Leehyunbin0131/dog/THIRD_PARTY_NOTICES.md

# Third-party notices

## ROBOTIS DYNAMIXEL references

ROBOTIS is the source of XL430-W250 / XM430-W210 actuator and horn reference geometry and dimensional information used in assembly documents and CAD reference objects. These are reference components, not user-designed or printable motor parts. Their inclusion in a composite assembly or render does not transfer their copyright to this project. No blanket open-source license or commercial redistribution permission for manufacturer CAD is asserted.

- XL430-W250: https://emanual.robotis.com/docs/en/dxl/x/xl430-w250/
- XM430-W210: https://emanual.robotis.com/docs/en/dxl/x/xm430-w210/
- XL drawing: https://www.robotis.com/service/download.php?no=772
- XM drawing: https://www.robotis.com/service/download.php?no=157

The complete manufacturer download archives are not mirrored. Native assembly/part files may include reference geometry; original mechanical derivative licensing does not override manufacturer rights. Printed spacer reference geometry is identified by its file name and is not an assertion of ownership over the corresponding stock hardware.

## Original Micro_Dog

Original mechanical work: © 2026 moieboy9999, CC BY-NC-SA 4.0. `licenses/UPSTREAM_ATTRIBUTION.md` is preserved for provenance, including inspiration and upstream third-party credits. No Unitree, Rhoban Microban, Pollen PCB, or Raspberry Pi third-party source is newly included by this adaptation.

## Fonts

The assembly PDF embeds renamed subsets derived from Noto Sans CJK, licensed under SIL Open Font License 1.1. The upstream font copyright and license are in `licenses/NOTO-OFL.txt`. Full font files are not redistributed. REV 3 includes renamed Noto-derived TrueType subset fonts and their generation/conversion scripts under docs/assembly/manual_v2/source; the font remains under SIL OFL 1.1.
