Leehyunbin0131/dog/ATTRIBUTION.md

# Attribution and modifications

## Original mechanical design

Micro_Dog, © 2026 moieboy9999: https://github.com/moieboy9999/Micro_Dog

Upstream reviewed commit: `68373f962d8916d3e81a07630844f12e3dfbe927`.
The original STEP supplied the mechanical design basis. Original license and attribution are retained in `LICENSE` and `licenses/UPSTREAM_ATTRIBUTION.md`.

Mechanical adaptations made in this X430 project include approximately 1.5× leg outlines; actual-size XL430/XM430 interfaces; motor clearance and cable passages; MR137ZZ 7×13×4 bearing stacks; retaining caps; mirrored left/right parts; roll carriers, pelvis yokes and fixed bearing support; finish/clearance changes; printed spacer references; and explanatory assembly documentation. The parametrized central body is a placeholder, not an original-body reproduction or completed structural design.

The resulting mechanical derivatives, CAD, STEP, STL, derived URDF/meshes, parameters and documentation are distributed under Creative Commons Attribution-NonCommercial-ShareAlike 4.0 International, subject to third-party exclusions below. Changes are not endorsed by the original author.
https://creativecommons.org/licenses/by-nc-sa/4.0/

## Software

Newly authored helper/generation/validation scripts are GPL-3.0-or-later, see `LICENSE-SOFTWARE`. The original project's control software, training scripts and policy weights are not copied into this repository. No claim is made that the original XL330 policy works with this X430 mechanism.

## Third-party exclusions

ROBOTIS actuator/horn reference geometry and other manufacturer data retain their respective rights; this project does not claim ownership or apply CC/GPL to those assets. See `THIRD_PARTY_NOTICES.md` for sources and scope. The upstream attribution file describes upstream content, not a declaration that every upstream asset is redistributed here.
