Leehyunbin0131/dog/docs/CAD_SOURCES.md

# Selected CAD editing sources

These documents preserve the relevant editable work, including hidden intermediate/reference objects. Exported final STL/STEP remains authoritative; source documents have not been fully recomputed or proven feature-by-feature equivalent. Select the final body rather than exporting every object.

- `RR_XL430_thigh_finish_v2_fine005.stl`: `cad/freecad/parts/RR_XL430_thigh_finish_v2_lean.FCStd`
- `LH_XL430_thigh_finish_v2_fine005.stl`: `cad/freecad/parts/LH_XL430_thigh_finish_v2.FCStd`
- `RR_shank_MR137ZZ4_fine005.stl`: `cad/freecad/parts/RR_shank_MR137ZZ4_working.FCStd`
- `LH_shank_MR137ZZ4_fine005.stl`: `cad/freecad/parts/LH_shank_MR137ZZ4.FCStd`
- `RR_shank_companion_original_shape_fine005.stl`: `cad/freecad/parts/RR_shank_companion_original_shape_working.FCStd`
- `LH_shank_companion_fine005.stl`: `cad/freecad/parts/LH_shank_companion.FCStd`
- `RR_XL430_knee_crank_original_shape_fine005.stl`: `cad/freecad/parts/RR_XL430_knee_crank_original_shape_working.FCStd`
- `RR_pushrod_original_shape_fine005.stl`: `cad/freecad/parts/RR_pushrod_original_shape_working.FCStd`
- `Large_retaining_cap_MR137ZZ4_fine005.stl`: `cad/freecad/parts/Large_retaining_cap_MR137ZZ4_working.FCStd`
- `Small_retaining_cap_original_fine005.stl`: `cad/freecad/parts/Small_retaining_cap_original.FCStd`
- `RR_foot_original_shape_fine005.stl`: `cad/freecad/parts/RR_foot_original_shape_working.FCStd`
- `XM430_roll_horn_carrier_finish_fine005.stl`: `cad/freecad/parts/XM430_roll_horn_carrier_finish.FCStd`
- `XL430_roll_bearing_carrier_MR137ZZ4_clearance_v2_fine005.stl`: `cad/freecad/parts/XL430_roll_bearing_carrier_MR137ZZ4_clearance_v2.FCStd`
- `Pelvis_roll_support_MR137ZZ4_clearance03_fine005.stl`: `cad/freecad/parts/Pelvis_roll_support_MR137ZZ4.FCStd`
- `RR_XM430_pelvis_yoke_checked_fine005.stl`: `cad/freecad/parts/RR_XM430_pelvis_yoke_working.FCStd`
- `LR_XM430_pelvis_yoke_fine005.stl`: `cad/freecad/parts/LR_XM430_pelvis_yoke.FCStd`
- `XL430_keyed_spacer_reference.stl`: `cad/freecad/parts/XL430_keyed_spacer_reference.FCStd`
- `XM430_case_spacer_reference_fine005.stl`: `cad/freecad/parts/XM430_case_spacer_reference.FCStd`

The exported STEP/STL specifies the final clearance03 support shape; inspect the source feature selection before re-exporting. Use restore_packed_files.py before opening the packed right-thigh document.
