Leehyunbin0131/dog/docs/assembly/manual_v2/assets/overview.png

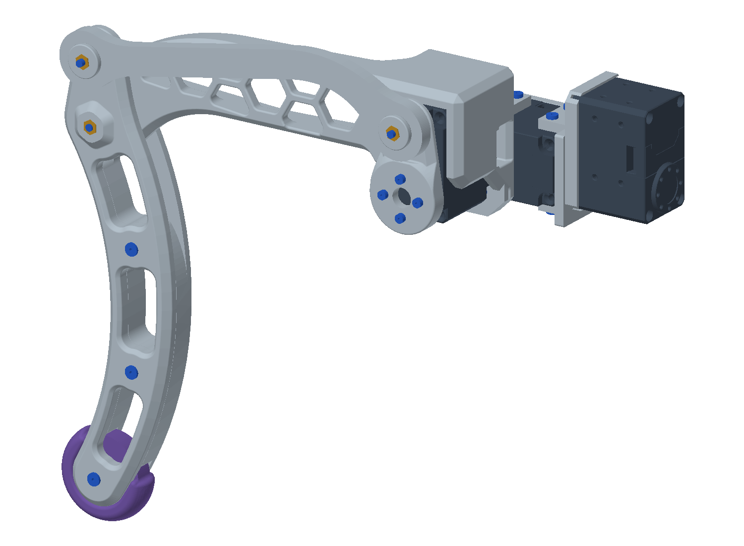
docs/assembly/manual_v2/assets/overview.png
