Leehyunbin0131/dog/images/62_RR_complete_leg_pelvis.jpg

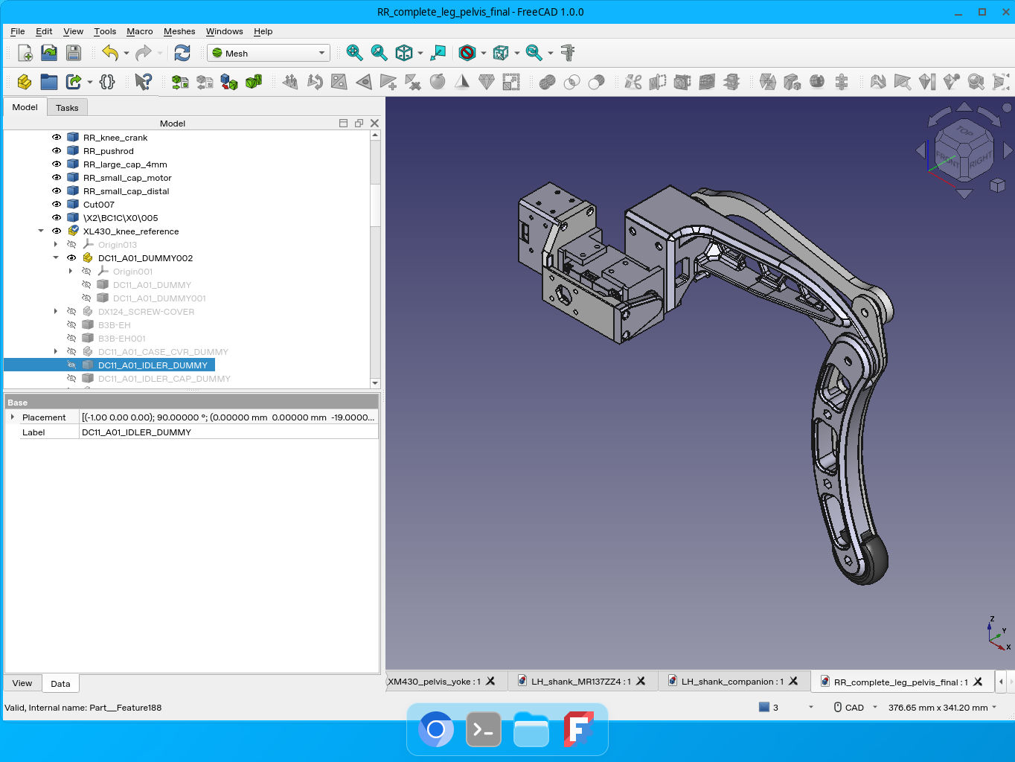
images/62_RR_complete_leg_pelvis.jpg
