Leehyunbin0131/dog/images/assembly/overview_a.png

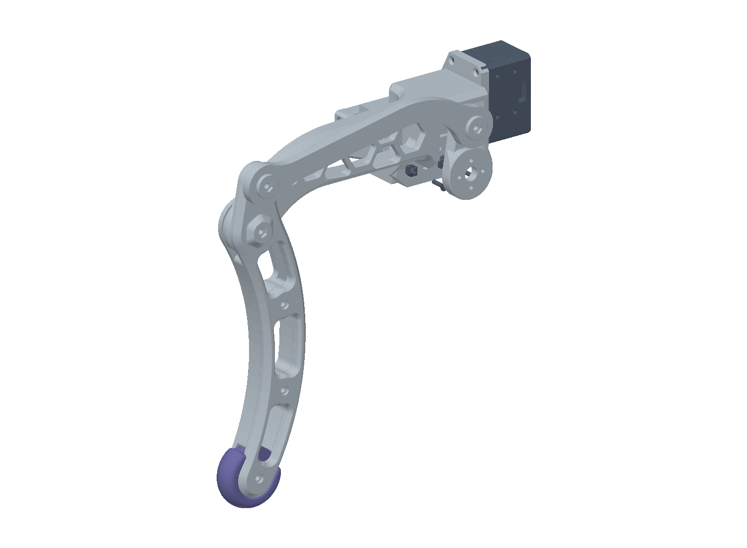
images/assembly/overview_a.png
