Leehyunbin0131/dog/docs/bom/printed_parts.csv

file | quantity | material | sha256
RR_XL430_thigh_finish_v2_fine005.stl | 2 | PLA | 6c28571a567d9a42b985946fea726201387cbd39cf7ea6b7587750b2f6ee943d
LH_XL430_thigh_finish_v2_fine005.stl | 2 | PLA | 9047f457ac42e8384424c823f7730fb696b8dfba642826761f44a489e81a110a
RR_shank_MR137ZZ4_fine005.stl | 2 | PLA | 9bbbfd65d6c0c338eb0b5cd08ecb12a54b652a8e96e306e003762d8ae54926e9
LH_shank_MR137ZZ4_fine005.stl | 2 | PLA | e1fa2028df4a93b5aff54ae1f663ef85ef9a0ecc1adec51dea8764f1c51b33ef
RR_shank_companion_original_shape_fine005.stl | 2 | PLA | ee0035df773160c7955a39d78ee668ffdc51e8afffd88681a85cce93f338b44b
LH_shank_companion_fine005.stl | 2 | PLA | 5df619ce2be21cb59259313106f591cdb59da83122bb4a03e0deb2da20906122
RR_XL430_knee_crank_original_shape_fine005.stl | 4 | PLA | 31f4d15e81daaf4329c76fde653677bb7d7fda65d8bbd32a9f8b8b8a7bb69c35
RR_pushrod_original_shape_fine005.stl | 4 | PLA | 095c1817cce63f73ddd0a658bb03e86bc8751b4c14e85299a5c08ce808242eee
Large_retaining_cap_MR137ZZ4_fine005.stl | 4 | PLA | 7b30682414906283c338cf347638e11aca3248c5bf40cbc997aa26874cf67d39
Small_retaining_cap_original_fine005.stl | 8 | PLA | ebaca69c9e65529709f184d23aeefeb28cba8705a0ec41c2ece9f4bec49af1ac
RR_foot_original_shape_fine005.stl | 4 | TPU95A | b5f29c3139329bb3a87ade8e3d312d9ac05d0036e463541a5a33e61598ef6748
XM430_roll_horn_carrier_finish_fine005.stl | 4 | PLA | e86779746acdd896fff15bee71d8153953dc7c26abd656b7c8151430c3bf7862
XL430_roll_bearing_carrier_MR137ZZ4_clearance_v2_fine005.stl | 4 | PLA | 5f95768f4dd9f3e8be56aca34b6cd4f709481c88ac20f55eb0a12fd7e7cb75df
Pelvis_roll_support_MR137ZZ4_clearance03_fine005.stl | 4 | PLA | 54bcd5b0998d45053a7d4befbd47951f954cba6353021bfae742af6fe5540ecc
RR_XM430_pelvis_yoke_checked_fine005.stl | 2 | PLA | ce570233bcb73c30af040ecb0e3a2f796170e2a8956bcaf9481e6f54b6487a49
LR_XM430_pelvis_yoke_fine005.stl | 2 | PLA | 94ebef8037e834c960f617b63dbd2d54cc14bb8e4b26ea74edc224b8c4df1634
XL430_keyed_spacer_reference.stl | 16 | PLA | 850a73b3b3b96892e2e7f3600beac49e5b664ec0a3137b1146a798042436e7ad
XM430_case_spacer_reference_fine005.stl | 16 | PLA | ac34d69db38a92e00b66f873a88f1ec3ee2fa27da3384529a1e3f1a959acd1fa
