Leehyunbin0131/dog/cad/freecad/assemblies/RR_complete_leg_pelvis_final.FCStd

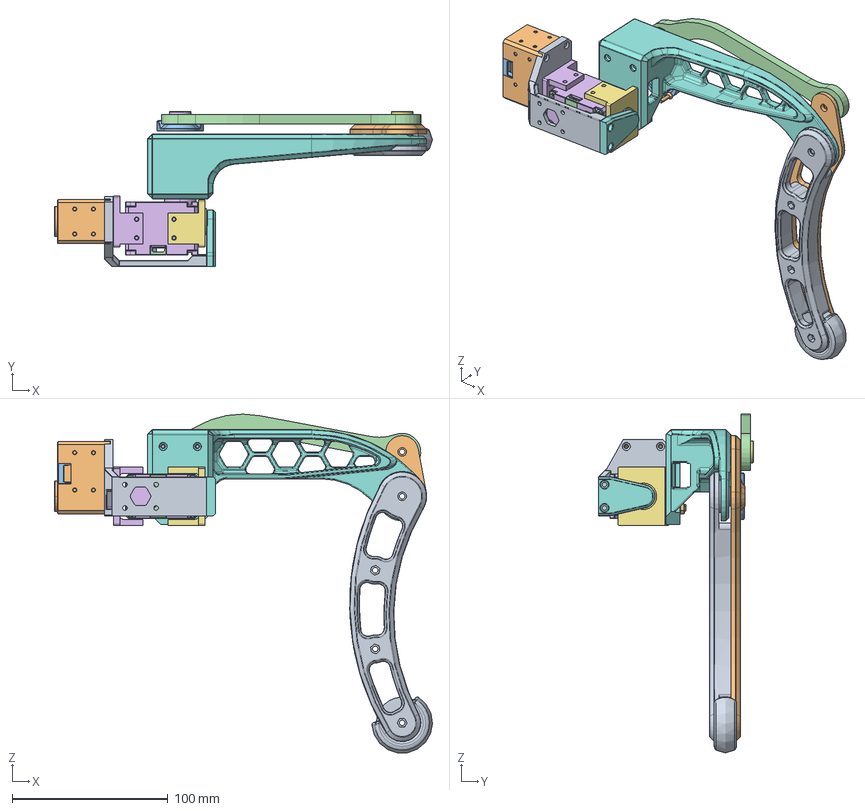
[picture p5: CAD file, 2026-10-17]
cad/freecad/assemblies/RR_complete_leg_pelvis_final.FCStd
242.7 x 99.8 x 217.6 mm
RR_inner_shank_4mm
RR_companion_shank
RR_knee_crank
RR_pushrod
RR_large_cap_4mm
RR_small_cap_motor
RR_small_cap_distal
\X2\BC1C\X0\005
DC11_A01_SPACER_DUMMY004
DC11_A01_SPACER_DUMMY005
DC11_A01_SPACER_DUMMY006
DC11_A01_SPACER_DUMMY007
DC11_A01_DUMMY003
DC11_A01_DUMMY004
B3B-EH002
B3B-EH003
DUMMY_DC12_3
WBH_M2_5X12_012
WBH_M2_5X12_013
WBH_M2_5X12_014
WBH_M2_5X12_015
DC12_A01_SPACER_RING_1_006
DC12_A01_SPACER_RING_1_007
DC12_A01_SPACER_RING_1_008
DC12_A01_SPACER_RING_1_009
DC12_A01_CVR_CABLE_5_1
