Leehyunbin0131/dog/cad/freecad/parts/RR_pushrod_original_shape_working.FCStd

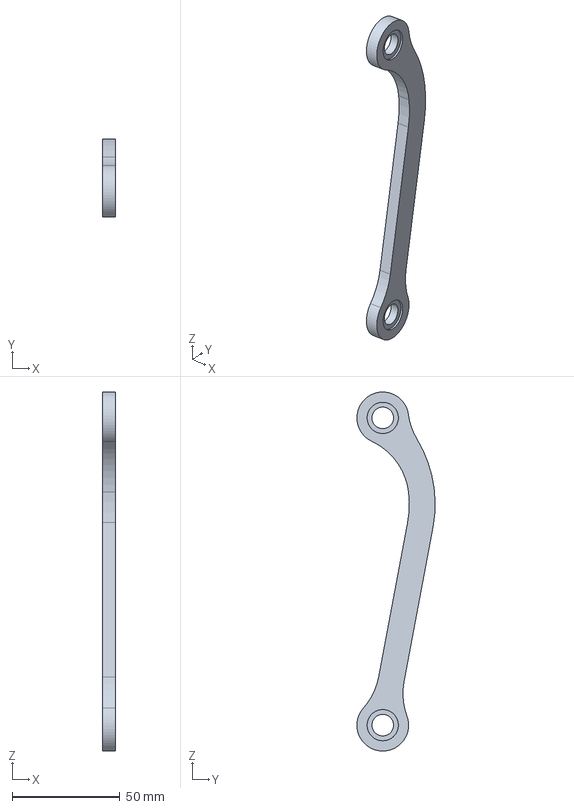
[picture p6: CAD file, 2026-10-17]
cad/freecad/parts/RR_pushrod_original_shape_working.FCStd
6.00 x 36.3 x 166.5 mm
