Leehyunbin0131/dog/cad/step/RR_XM430_pelvis_yoke_checked.step

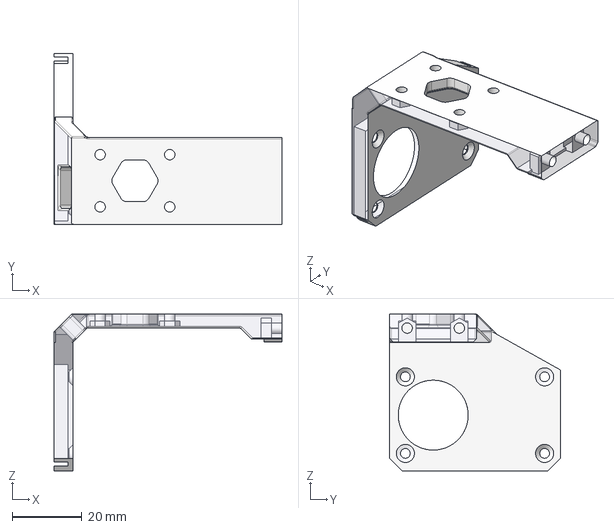
[picture p7: CAD file, 2026-10-17]
cad/step/RR_XM430_pelvis_yoke_checked.step
65.5 x 49.0 x 45.0 mm
