Leehyunbin0131/dog/cad/stl/RR_XL430_knee_crank_original_shape_fine005.stl

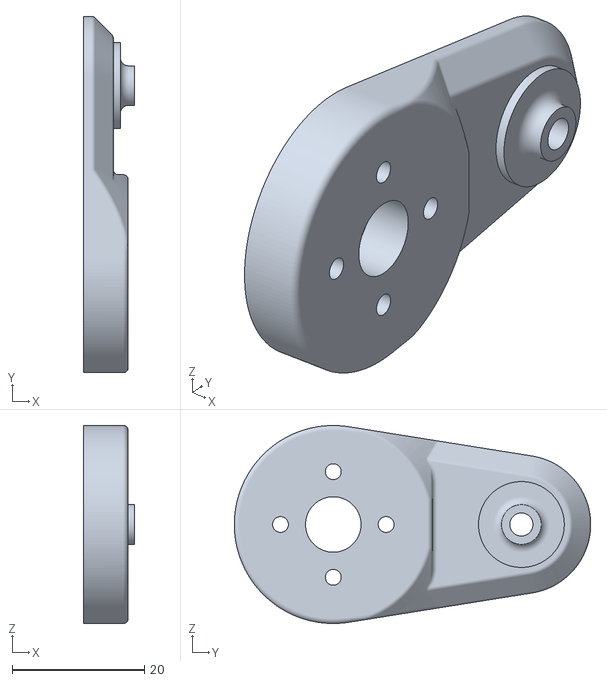
[picture p8: CAD file, 2026-10-17]
cad/stl/RR_XL430_knee_crank_original_shape_fine005.stl
7.69 x 54.0 x 30.0
