Leehyunbin0131/dog/descriptions/micro_dog_x430_description/meshes/RR_base_printed.stl

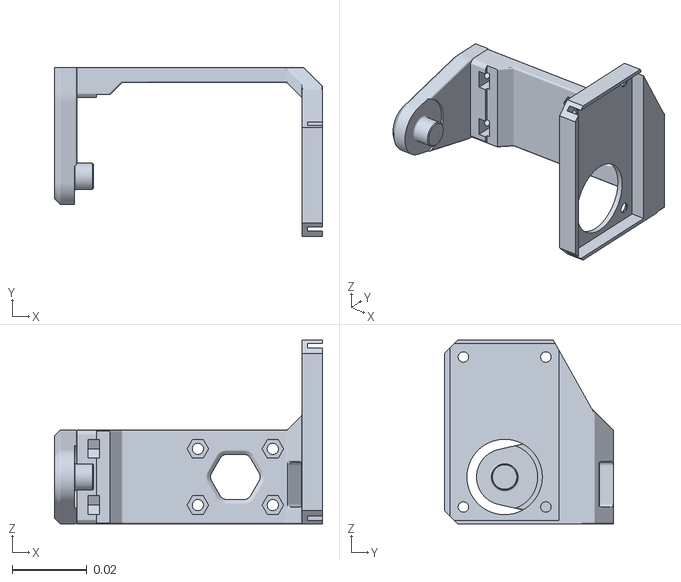
[picture p9: CAD file, 2026-10-17]
descriptions/micro_dog_x430_description/meshes/RR_base_printed.stl
0.0715 x 0.045 x 0.049
