Leehyunbin0131/dog/cad/freecad/assemblies/Micro_Dog_X430_four_corner_overview.FCStd

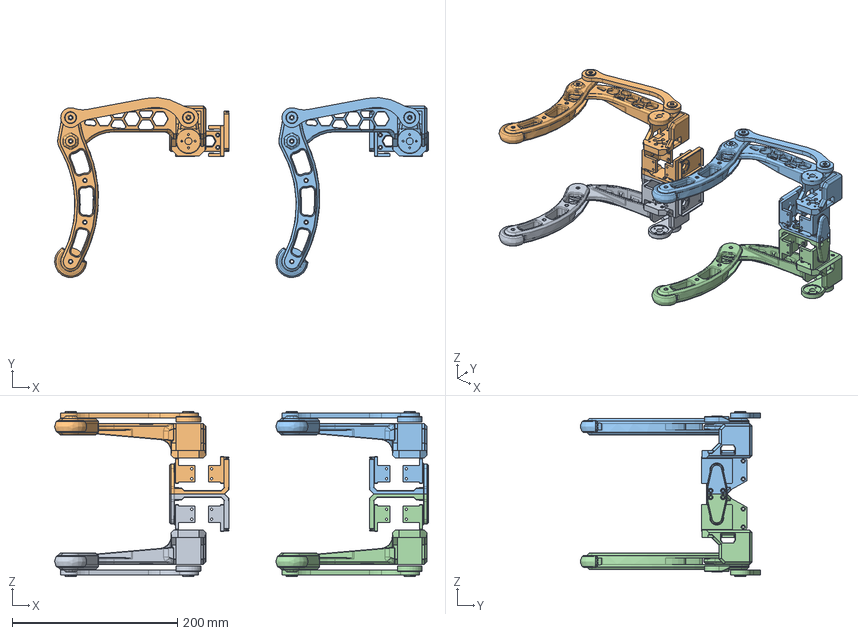
[picture p10: CAD file, 2026-10-17]
cad/freecad/assemblies/Micro_Dog_X430_four_corner_overview.FCStd
452.2 x 217.4 x 199.6 mm
LR_module_H
RR_module_H
FR_module_H
FL_module_H
