Leehyunbin0131/dog/cad/freecad/parts/Pelvis_roll_support_MR137ZZ4.FCStd

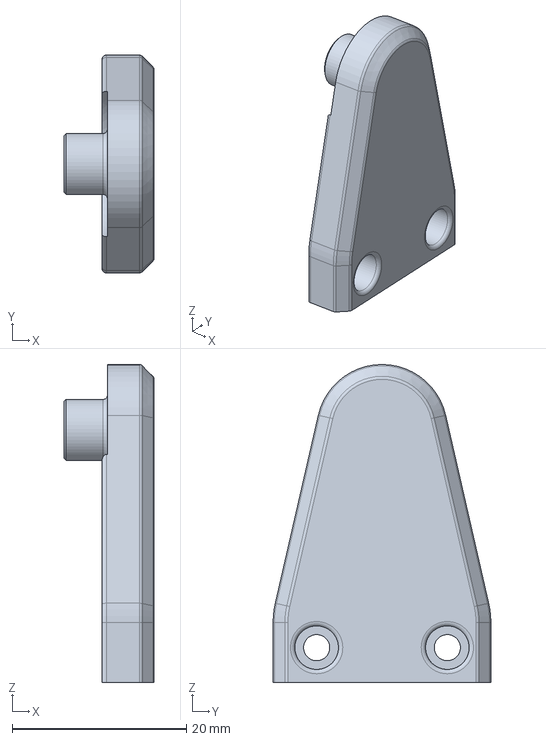
[picture p11: CAD file, 2026-10-17]
cad/freecad/parts/Pelvis_roll_support_MR137ZZ4.FCStd
10.4 x 25.0 x 36.5 mm
