Leehyunbin0131/dog/cad/step/XM430_case_spacer_reference.step

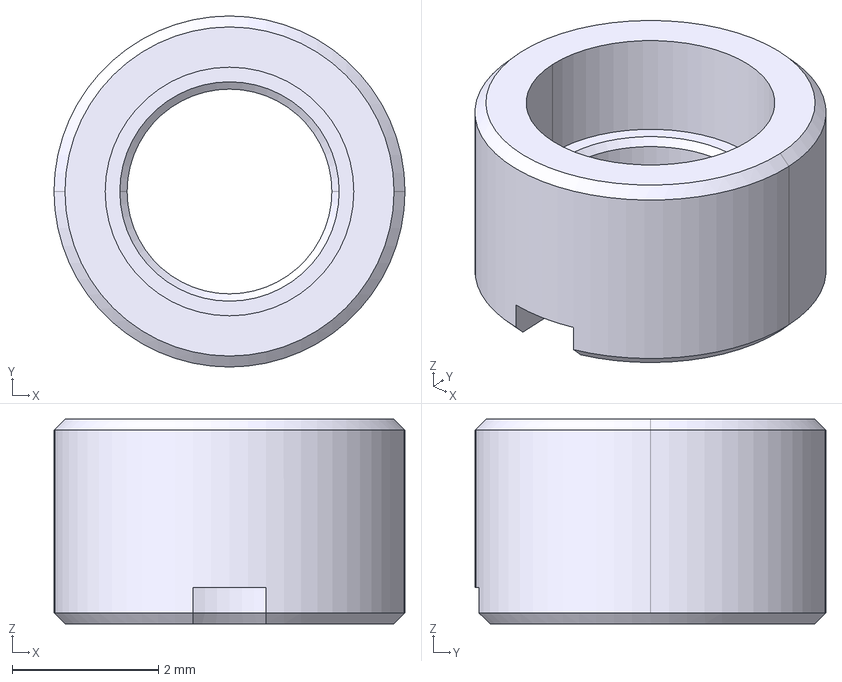
[picture p12: CAD file, 2026-10-17]
cad/step/XM430_case_spacer_reference.step
4.80 x 4.80 x 2.80 mm
