Leehyunbin0131/dog/cad/stl/Large_retaining_cap_MR137ZZ4_fine005.stl

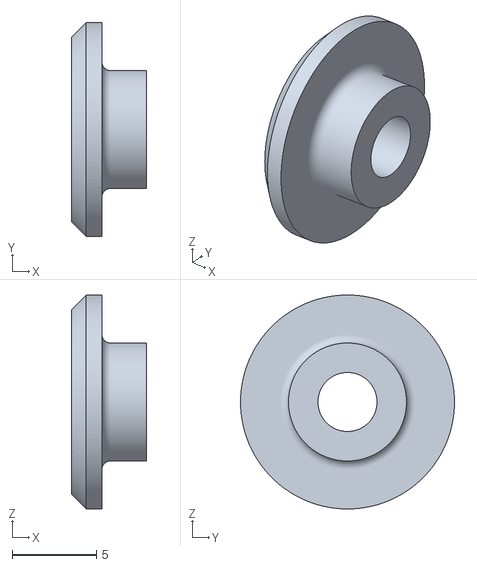
[picture p13: CAD file, 2026-10-17]
cad/stl/Large_retaining_cap_MR137ZZ4_fine005.stl
4.42 x 12.7 x 12.7
