Leehyunbin0131/dog/descriptions/micro_dog_x430_description/meshes/RL_thigh_motor.stl

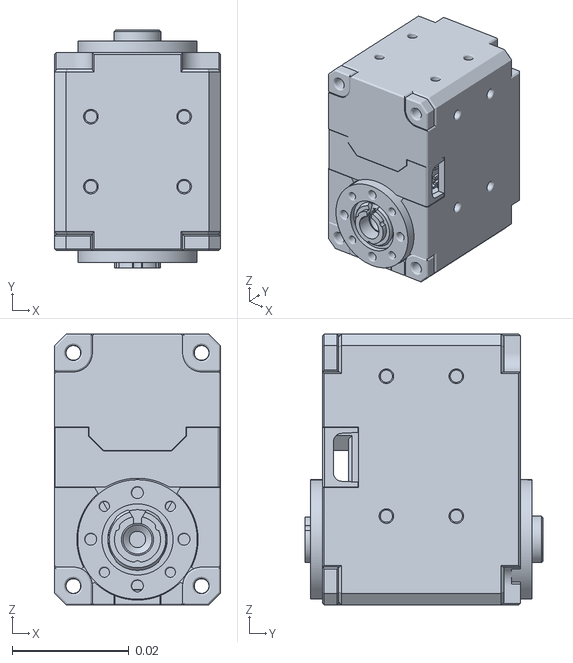
[picture p14: CAD file, 2026-10-17]
descriptions/micro_dog_x430_description/meshes/RL_thigh_motor.stl
0.0285 x 0.0409 x 0.0465
