Leehyunbin0131/dog/cad/freecad/parts/RR_shank_companion_original_shape_working.FCStd

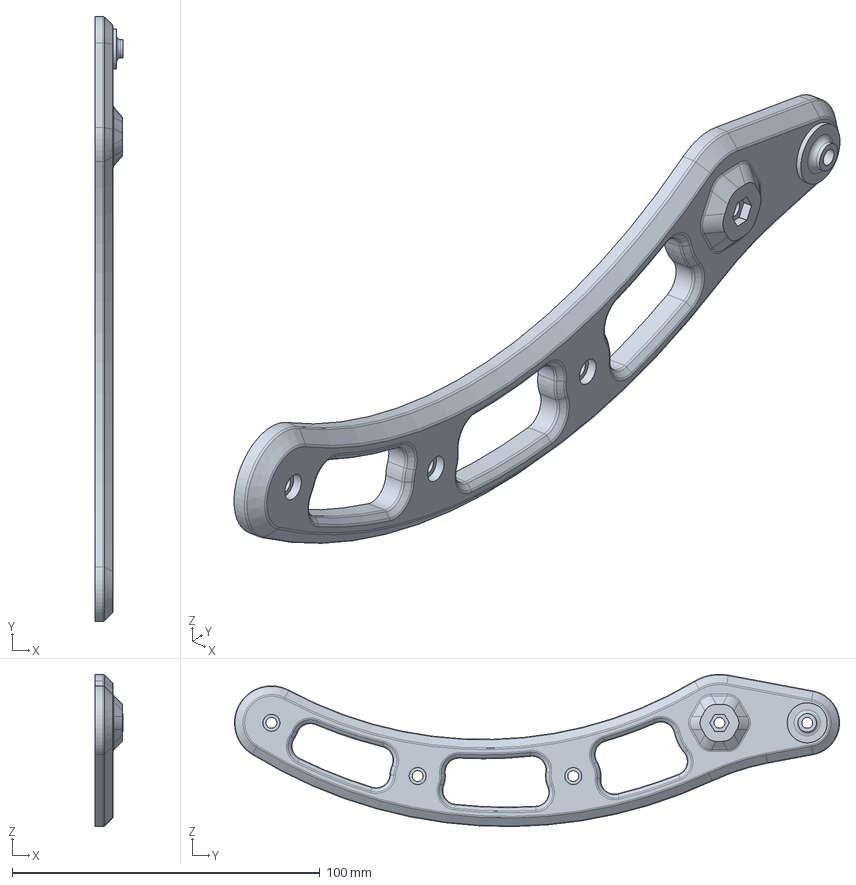
[picture p15: CAD file, 2026-10-17]
cad/freecad/parts/RR_shank_companion_original_shape_working.FCStd
9.25 x 196.5 x 49.4 mm
