Leehyunbin0131/dog/cad/step/XL430_keyed_spacer_reference.step

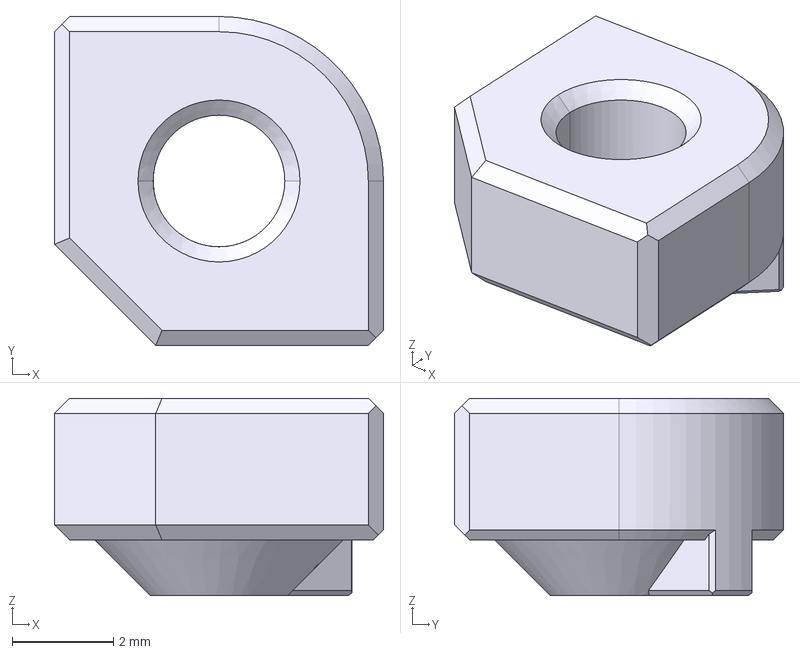
[picture p16: CAD file, 2026-10-17]
cad/step/XL430_keyed_spacer_reference.step
6.50 x 6.50 x 3.90 mm
