Leehyunbin0131/dog/cad/stl/LH_shank_MR137ZZ4_fine005.stl

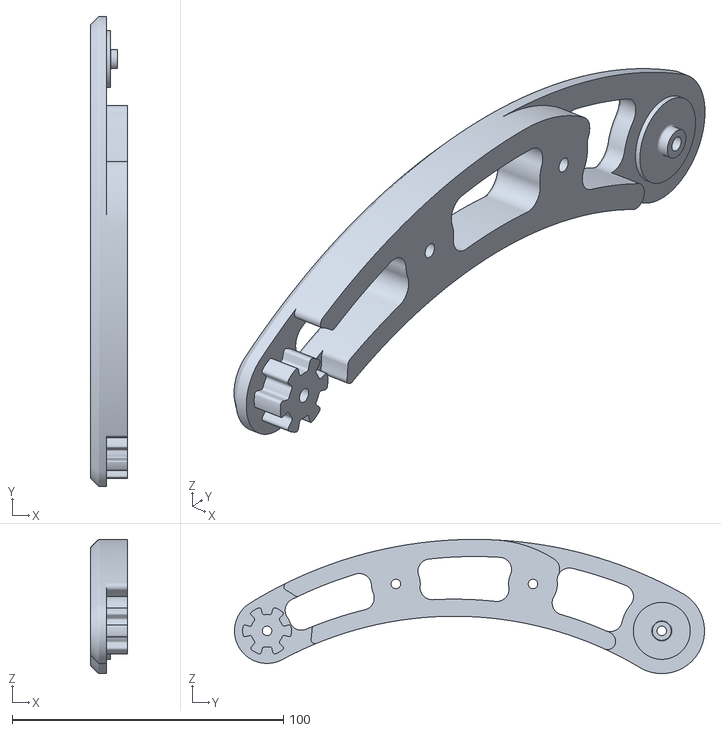
[picture p17: CAD file, 2026-10-17]
cad/stl/LH_shank_MR137ZZ4_fine005.stl
13.7 x 173.2 x 49.5
