Leehyunbin0131/dog/cad/step/RR_XL430_thigh_finish_v2.step

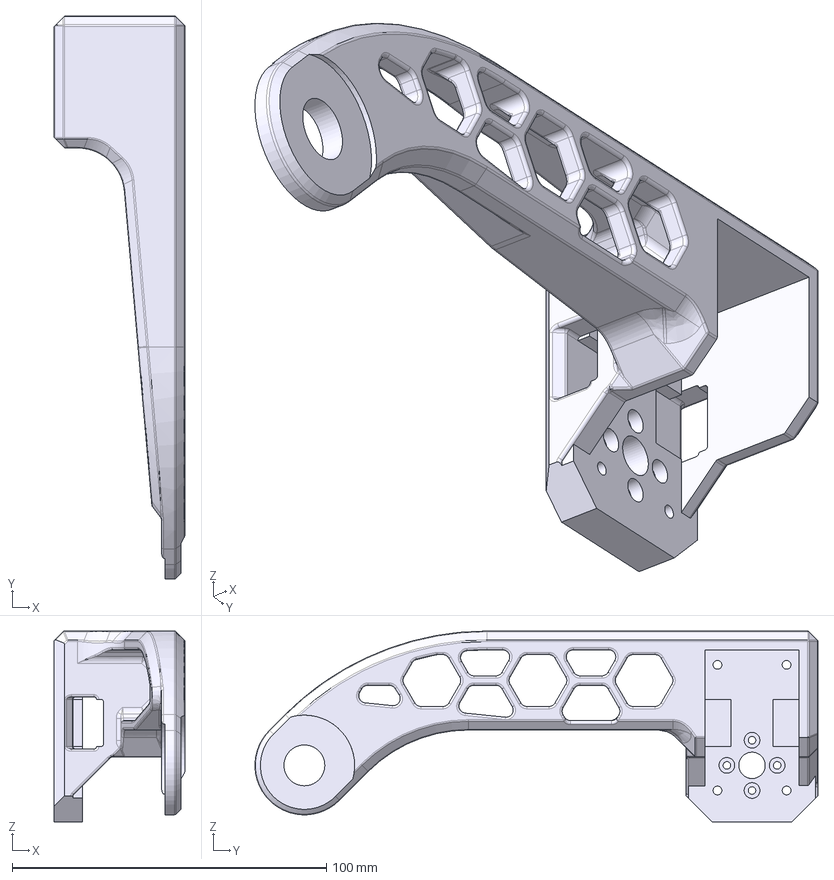
[picture p18: CAD file, 2026-10-17]
cad/step/RR_XL430_thigh_finish_v2.step
41.6 x 179.2 x 60.8 mm
