Leehyunbin0131/dog/descriptions/micro_dog_x430_description/meshes/FR_hip_printed.stl

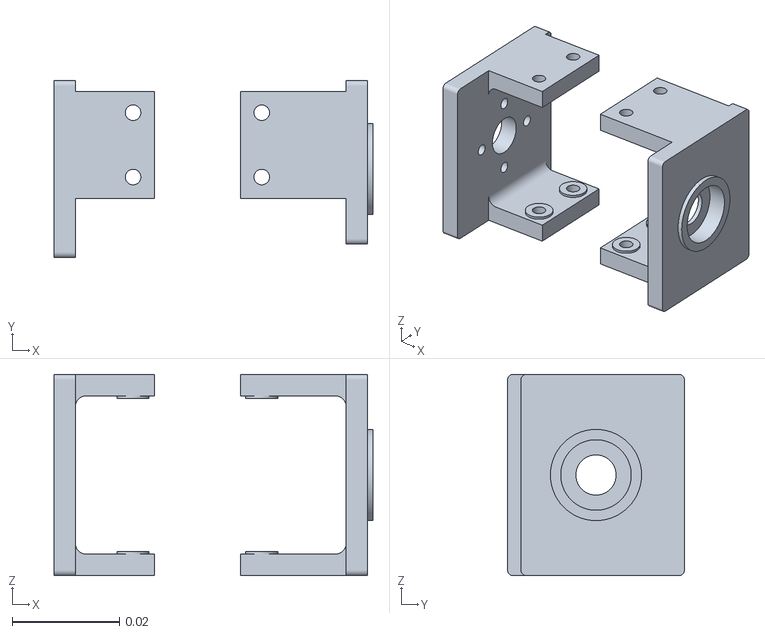
[picture p19: CAD file, 2026-10-17]
descriptions/micro_dog_x430_description/meshes/FR_hip_printed.stl
0.0595 x 0.033 x 0.0375
