Leehyunbin0131/dog/cad/stl/XL430_roll_bearing_carrier_MR137ZZ4_clearance_v2_fine005.stl

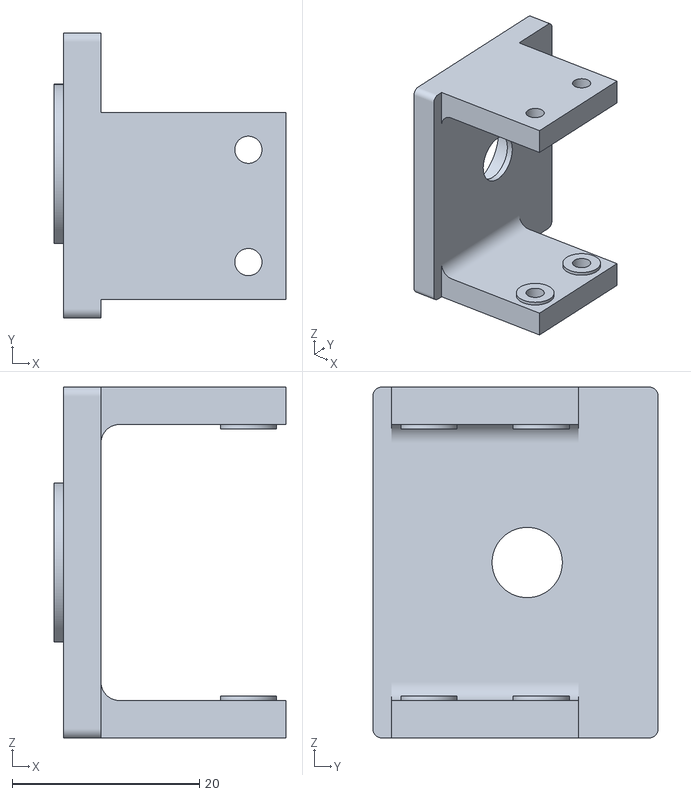
[picture p20: CAD file, 2026-10-17]
cad/stl/XL430_roll_bearing_carrier_MR137ZZ4_clearance_v2_fine005.stl
24.8 x 30.5 x 37.5
