Leehyunbin0131/dog/descriptions/micro_dog_x430_description/meshes/FR_thigh_printed.stl

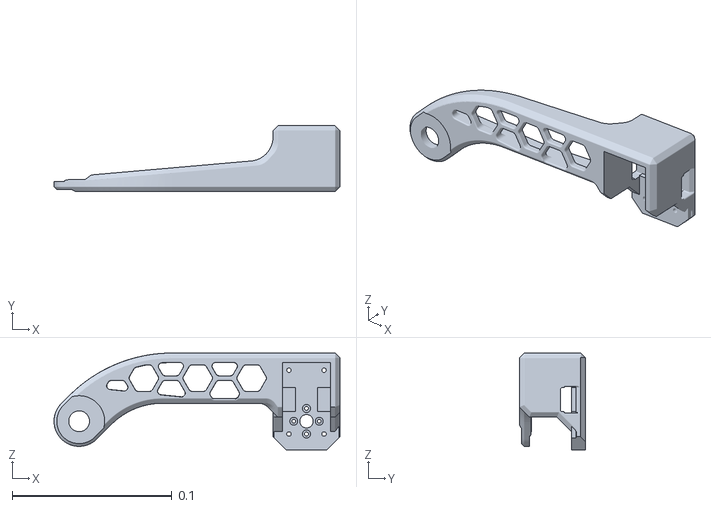
[picture p21: CAD file, 2026-10-17]
descriptions/micro_dog_x430_description/meshes/FR_thigh_printed.stl
0.179 x 0.0416 x 0.0608
