Leehyunbin0131/dog/descriptions/micro_dog_x430_description/meshes/RL_foot_foot.stl

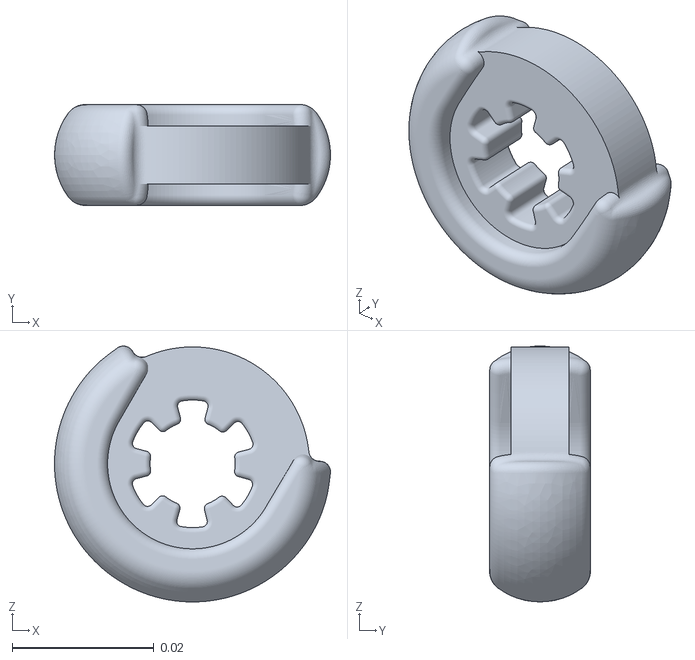
[picture p22: CAD file, 2026-10-17]
descriptions/micro_dog_x430_description/meshes/RL_foot_foot.stl
0.039 x 0.0143 x 0.0361
