Leehyunbin0131/dog/cad/stl/RR_foot_original_shape_fine005.stl

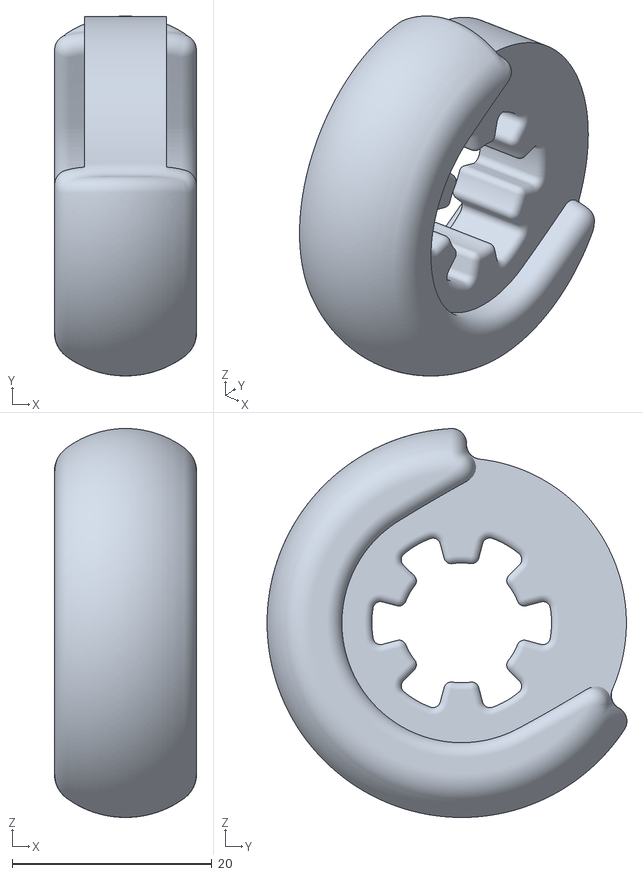
[picture p23: CAD file, 2026-10-17]
cad/stl/RR_foot_original_shape_fine005.stl
14.2 x 36.1 x 39.0
