Leehyunbin0131/dog/descriptions/micro_dog_x430_description/meshes/FL_shank_printed.stl

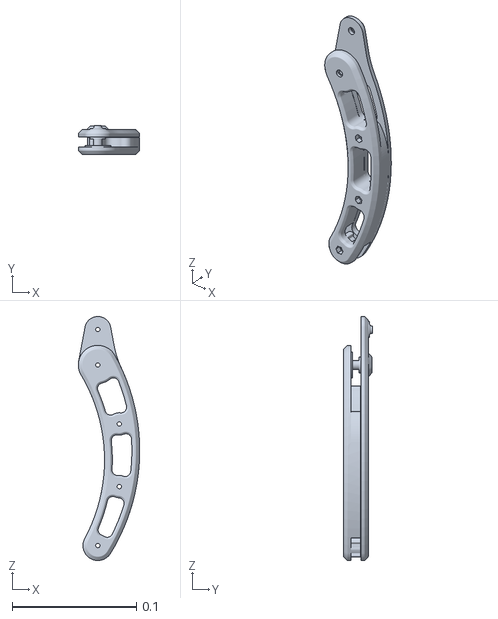
[picture p24: CAD file, 2026-10-17]
descriptions/micro_dog_x430_description/meshes/FL_shank_printed.stl
0.0495 x 0.0231 x 0.196
