Leehyunbin0131/dog/cad/stl/Small_retaining_cap_original_fine005.stl

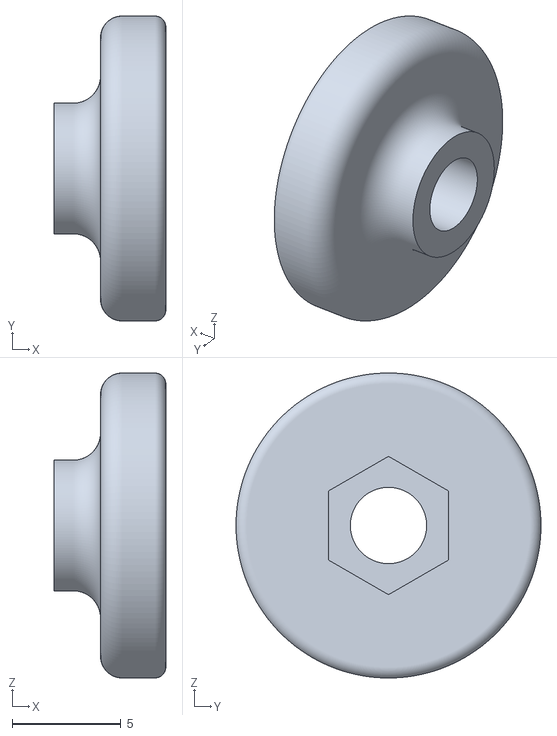
[picture p25: CAD file, 2026-10-17]
cad/stl/Small_retaining_cap_original_fine005.stl
5.12 x 14.0 x 14.0
