Leehyunbin0131/dog/descriptions/micro_dog_x430_description/meshes/FR_base_motor.stl

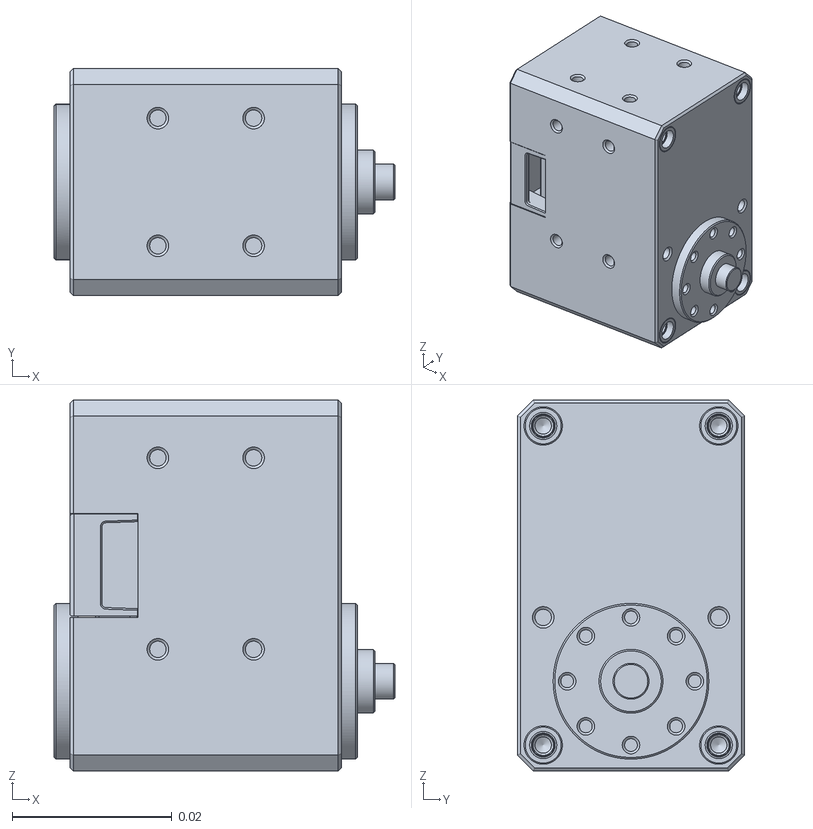
[picture p26: CAD file, 2026-10-17]
descriptions/micro_dog_x430_description/meshes/FR_base_motor.stl
0.0427 x 0.0285 x 0.0465
