Leehyunbin0131/dog/cad/step/LH_shank_companion.step

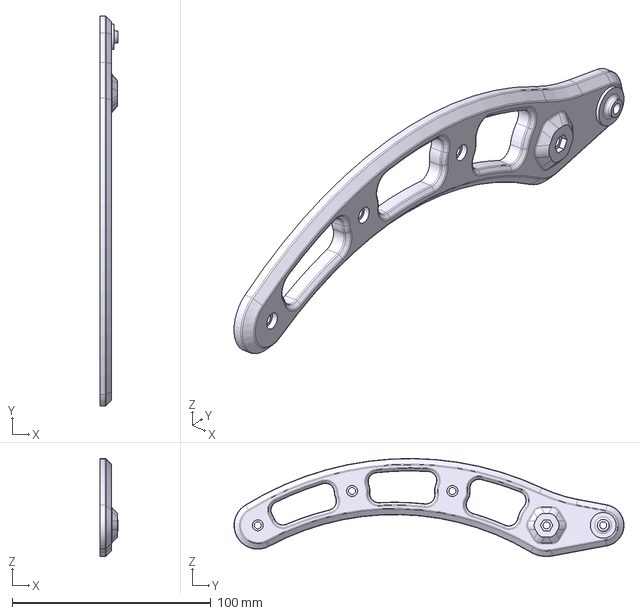
[picture p27: CAD file, 2026-10-17]
cad/step/LH_shank_companion.step
9.25 x 196.5 x 49.4 mm
