Leehyunbin0131/dog/cad/stl/XM430_roll_horn_carrier_finish_fine005.stl

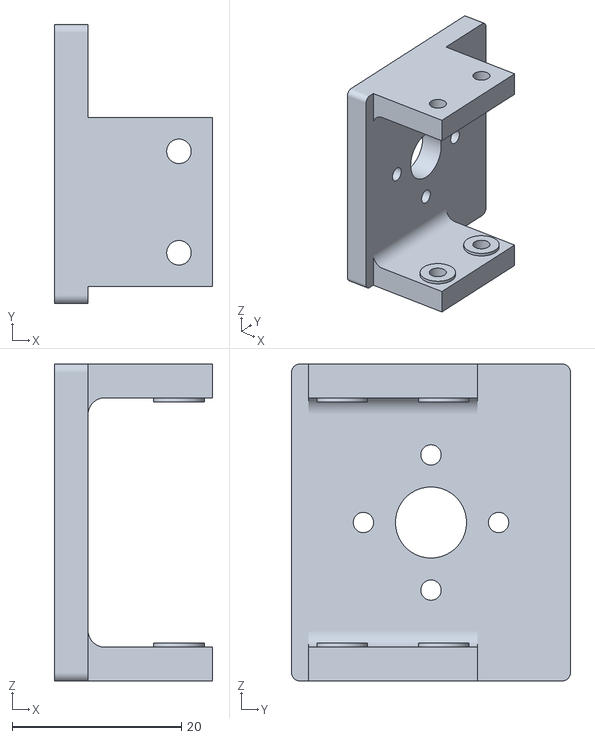
[picture p28: CAD file, 2026-10-17]
cad/stl/XM430_roll_horn_carrier_finish_fine005.stl
18.8 x 33.0 x 37.5
