Leehyunbin0131/dog/(list of files, cad)

Other CAD files:
cad/step/RR_pushrod_original_shape.step
cad/stl/RR_XM430_pelvis_yoke_checked_fine005.stl
descriptions/micro_dog_x430_description/meshes/FL_base_printed.stl
cad/freecad/parts/Large_retaining_cap_MR137ZZ4_working.FCStd
descriptions/micro_dog_x430_description/meshes/RR_hip_motor.stl
cad/freecad/parts/RR_XL430_knee_crank_original_shape_working.FCStd
cad/stl/Pelvis_roll_support_MR137ZZ4_clearance03_fine005.stl
cad/freecad/parts/RR_shank_MR137ZZ4_working.FCStd
cad/step/Large_retaining_cap_MR137ZZ4.step
cad/freecad/parts/RR_XM430_pelvis_yoke_working.FCStd
cad/step/LR_XM430_pelvis_yoke.step
cad/stl/RR_shank_companion_original_shape_fine005.stl
cad/freecad/parts/RR_foot_original_shape_working.FCStd
cad/step/Pelvis_roll_support_MR137ZZ4_clearance03.step
cad/stl/LH_shank_companion_fine005.stl
descriptions/micro_dog_x430_description/meshes/FL_hip_motor.stl
cad/step/RR_shank_MR137ZZ4.step
cad/step/RR_foot_original_shape.step
cad/step/LH_XL430_thigh_finish_v2.step
cad/stl/RR_pushrod_original_shape_fine005.stl
descriptions/micro_dog_x430_description/meshes/RL_base_motor.stl
descriptions/micro_dog_x430_description/meshes/RL_thigh_printed.stl
cad/step/RR_XL430_knee_crank_original_shape.step
cad/stl/XM430_case_spacer_reference_fine005.stl
descriptions/micro_dog_x430_description/meshes/RR_hip_printed.stl
cad/step/RR_shank_companion_original_shape.step
cad/stl/LR_XM430_pelvis_yoke_fine005.stl
descriptions/micro_dog_x430_description/meshes/RR_thigh_motor.stl
cad/step/XM430_roll_horn_carrier_finish.step
cad/stl/RR_shank_MR137ZZ4_fine005.stl
descriptions/micro_dog_x430_description/meshes/RL_hip_motor.stl
cad/step/Small_retaining_cap_original.step
descriptions/micro_dog_x430_description/meshes/FL_thigh_motor.stl
cad/step/XL430_roll_bearing_carrier_MR137ZZ4_clearance_v2.step
descriptions/micro_dog_x430_description/meshes/FL_thigh_printed.stl
cad/step/LH_shank_MR137ZZ4.step
descriptions/micro_dog_x430_description/meshes/RR_shank_printed.stl
descriptions/micro_dog_x430_description/meshes/RL_base_printed.stl
descriptions/micro_dog_x430_description/meshes/RL_shank_printed.stl
descriptions/micro_dog_x430_description/meshes/FL_base_motor.stl
descriptions/micro_dog_x430_description/meshes/RR_base_motor.stl
descriptions/micro_dog_x430_description/meshes/FR_thigh_motor.stl
descriptions/micro_dog_x430_description/meshes/FL_foot_foot.stl
descriptions/micro_dog_x430_description/meshes/RL_hip_printed.stl
descriptions/micro_dog_x430_description/meshes/FL_hip_printed.stl
descriptions/micro_dog_x430_description/meshes/RR_thigh_printed.stl
descriptions/micro_dog_x430_description/meshes/FR_hip_motor.stl
descriptions/micro_dog_x430_description/meshes/FR_base_printed.stl
descriptions/micro_dog_x430_description/meshes/RR_foot_foot.stl
descriptions/micro_dog_x430_description/meshes/FR_foot_foot.stl
descriptions/micro_dog_x430_description/meshes/FR_shank_printed.stl
cad/freecad/parts/LH_XL430_thigh_finish_v2.FCStd
cad/freecad/parts/LH_shank_MR137ZZ4.FCStd
cad/freecad/parts/LH_shank_companion.FCStd
cad/freecad/parts/LR_XM430_pelvis_yoke.FCStd
cad/freecad/parts/Small_retaining_cap_original.FCStd
cad/freecad/parts/XL430_keyed_spacer_reference.FCStd
cad/freecad/parts/XL430_roll_bearing_carrier_MR137ZZ4_clearance_v2.FCStd
cad/freecad/parts/XM430_case_spacer_reference.FCStd
cad/freecad/parts/XM430_roll_horn_carrier_finish.FCStd
cad/stl/XL430_keyed_spacer_reference.stl
