Leehyunbin0131/dog/images/assembly/README.md

# Legacy illustration set

These are retained revision-1 supplemental images. For the current corrected assembly figures, use [REV 2 assets](../../docs/assembly/manual_v2/assets/) and the [current assembly PDF](../../docs/assembly/Micro_Dog_X430_Assembly_Manual_KO.pdf).
