Leehyunbin0131/dog/docs/assembly/Micro_Dog_fastener_dimensional_audit.txt

Micro_Dog X430 최종 기구 — 체결부 치수 감사
대상: RR_complete_leg_pelvis_final.FCStd 및 최종 출력 안내/manifest
범위: 중앙 몸체 제외 네 다리. 8 XL430-W250 + 4 XM430-W210은 보유품.
검사 방식: 저장 CAD의 원통/평면/육각 자리 좌표를 읽기 전용으로 측정. 설계 수정 없음.
아래는 명목 CAD와 지정 표준 체결품을 맞춘 선정이다. 실물 출력 공차, 체결 토크/하중, 전 가동 범위 검증 결과로 표현하면 안 된다.

1. 네 다리용 선정 수량(여분 제외)
M2 × 8 mm 육각렌치 원통머리(ISO 4762): 32개 — 피치 혼16 + 무릎 크랭크 혼16
M2 × 6 mm 육각렌치 원통머리(ISO 4762): 16개 — 롤 혼
M2 평와셔, 내경2.2 × 외경5 × 두께0.3 mm: 16개 — 위 롤 혼 나사 각각1개
M2.6 × 8 mm 둥근/팬머리 태핑나사, ROBOTIS XL430 플라스틱 케이스용 지정 형식: 32개 — 피치 측면. 일반 M2.6 기계나사 아님
M2.5 × 20 mm 십자90°접시머리(DIN 965/ISO 7046-2, 머리외경4.7 이하): 16개 — 무릎 XL 뒤쪽
M2.5 × 14 mm 십자90°접시머리(DIN 965/ISO 7046-2, 머리외경4.7 이하·높이1.5 이하): 16개 — XM 앞쪽 요크
M2.5 × 8 mm 육각렌치 원통머리(ISO 4762): 8개 — 고정 지지대–요크
M2.5 일반 육각너트, 대변5 × 두께2 mm: 8개 — 고정 지지대–요크
M3 × 22 mm 육각렌치 원통머리(ISO 4762): 4개 — 큰 다리 관절
M3 × 12 mm 육각렌치 원통머리(ISO 4762): 4개 — 푸시로드 모터쪽
M3 × 14 mm 육각렌치 원통머리(ISO 4762): 4개 — 푸시로드 종아리쪽
M3 × 18 mm 육각렌치 원통머리(ISO 4762): 12개 — 종아리 중간8 + 발4
M3 일반 육각너트(DIN 934), 대변5.5 × 두께2.4 mm: 24개
M3 위치에는 평와셔를 추가하지 않는 길이 선정. 일반 M3 와셔 외경은 기존 머리 포켓에 맞지 않는다.

베어링: 7×13×4 mm MR137ZZ 8개, 6×10×2.5 mm 8개.
XL 스페이서16 + XM 스페이서16은 출력품에 포함. 별도 구매 불필요.
혼12개/혼 중심 고정나사12개/모터 케이블은 모터 보유품에서 재사용 여부 확인. 이 목록은 모터 패키지 동봉품 재고를 확인한 목록은 아니다.

2. M3 실측과 길이 계산
좌표는 RR 다리 Part 내부 좌표이며 축은 X이다. 머리 아래에서 길이를 잰다.
머리 ISO4762 M3: 외경5.5, 높이3. 너트 DIN934: AF5.5,t2.4,pitch0.5.

큰 관절, 한 다리1:
축 Y=-142.5,Z=-85.5. 머리 받침X32.9375, 너트 받침X51.8125. 사이18.875.
22 -18.875 -2.4 =0.725 mm가 너트 밖으로 나온다.
머리 포켓 Ø5.5, 깊이2, 머리1 mm 돌출. 너트 자리깊이2, 너트0.4 mm 돌출. 돌출 자체는 조립 불량이 아니다.
근거: 251 Face139/207,252 Faces171–180/181,255 Face8.

작은 관절 모터쪽, 한 다리1:
축 Y=0,Z=-57. 머리 받침X49.5, 너트 받침X57.3125. 사이7.8125.
12 -7.8125 -2.4 =1.7875 mm 너트 밖 돌출.
머리 포켓 Ø5.5 깊이3. 너트 AF5.5 깊이2,0.4 mm 돌출.
근거: 253 Faces69/72/73,256 Faces1–6/13/16.

작은 관절 종아리쪽, 한 다리1:
축 Y=-142.5,Z=-57. 머리 받침X47.8125, 너트 받침X57.1875. 사이9.375.
14 -9.375 -2.4 =2.225 mm 너트 밖 돌출.
머리 포켓 Ø5.5 깊이3. 너트 AF5.5 깊이2.
근거: 252 Faces144/177/182,257 Faces1–6/13/16.

종아리 중간 두 곳 및 발 한 곳, 한 다리3:
중간 축 Y=-125.21717,Z=-132.98419 및 -183.51581; 발 Y=-142.5,Z=-231.
머리 받침X48.8125, 너트 받침X34.9375, 방향 -X. 사이13.875.
18 -13.875 -2.4 =1.725 mm 너트 밖 돌출.
머리 포켓 Ø5.5 깊이2: 머리1 mm 돌출. 너트자리 AF5.5 깊이4: 너트는1.6 mm 들어앉는다.
근거: 251 Faces44/53/122/131/154–187/205/206,252 Faces22/44/53/118/129/138.

이 여섯 축의 제안 나사 샹크와 머리 원통 외곽을 저장 자세에서 점 샘플로 대조하여 출력물/참조 모터와의 내부 겹침이 발견되지 않았다. 단순 점 샘플이므로 정밀 연속 충돌 해석이나 전 가동범위 검증으로 볼 수 없다.

3. 골반 지지대–요크: 기존 안내 M3 8곳을 M2.5 8곳으로 정정
두 축 Y=-36.5,Z=-2.5 및 -17.5. 지지대2.5+요크3=그립5.5.
머리 받침X58, 너트 받침X52.5, 막힌 뒷벽X49.5. 최대 축방향 공간8.5.
머리자리 Ø5×깊이3, 너트자리 AF5×깊이3, 관통구멍Ø3.
M2.5 원통머리 Ø4.5×높이2.5, 너트 AF5×2는 명목상 맞는다.
M2.5×8: 너트 밖0.5 mm, 뒷벽까지0.5 mm 남는다. 와셔 없음.
M3 Ø5.5 머리와 AF5.5 너트는 이 자리에 맞지 않는다.
원본 support064 Faces3/5/47/49 및 yoke063 Faces206–219에도 동일한 포켓이 존재하여 원본부터 이어진 M2.5 크기의 자리다. 명시된 원본 나사 BOM은 발견하지 못했으나 기하학상 일반 M2.5 조합으로 정정하는 것이 타당하다.
최종 근거: 262 Faces24/25/40/41/51/52;263 Faces100/101/109/113/121/122.
머리는 +X에서 삽입, 너트는 +Y로 측면 삽입. 주변 부품을 닫기 전에 너트를 넣는다.

4. M2 혼 체결
피치 출력물 두께6 mm: 258 Faces231/232/233/235, X3..9. M2×8이면2 mm 삽입.
크랭크 두께5.25 mm:253 Faces62/63/65/66, X48..53.25. M2×8이면2.75 mm 삽입.
XL 공식 혼 최대삽입3.5 mm 이내이다. 피치/크랭크 실제 모터 CAD의 M2구멍4개는 출력물의 카드널 PCD16 패턴과 일치한다. Ø1.7 평구멍4개는45° 떨어져 있으며 사용하지 않는다.
혼 확인 근거: 실제 모터 leaf Part__Feature 및 Part__Feature215 Faces226–242(M2),244–254(Ø1.7).
롤 출력물 두께4 mm:260 Faces16/17/19/20, X-4..0. M2×6에0.3 mm 평와셔를 쓰면1.7 mm 삽입. XM 공식 혼 최대2 mm보다0.3 mm 작다.
롤의 머리면은 X0, 와셔+머리 높이는2.3 mm. 피치 모터 실제 케이스 전역X최소3.5이므로 저장 자세에서 축방향1.2 mm의 공간이 남는다. 롤 혼 나사자리에는 머리 포켓이 없어서 외경5 mm 와셔를 쓸 수 있다.

5. XL 뒤쪽 접시머리20의 근거
stock rear FHS_M2_5X014는 머리 끝X14.6, 나사끝X24.6(길이10).
새 대퇴의90°접시자리: r2.5 at X4.2, r1.4 at X5.3; 입구 보어Ø5.2 X3..4.2.
머리Ø4.7의90°접시나사는 명목 상면X4.35, 길이20 끝X24.35. 기존 끝보다0.25 mm 덜 들어간다.
동일 Ø5 모형 머리로 계산하면 상면X4.2, 끝X24.2(기존보다0.4 mm 덜).
이는 기존 삽입 길이와의 명목 비교이며 제조사가 정의한 실제 구멍바닥 깊이는 아니다. 실제 구매 나사의 머리외경,90°각도,길이공차와 출력 치수 확인을 해야 한다.

6. 출력 공차 주의
다리 M3 머리 포켓 Ø5.5와 M3 머리 최대외경5.5는 명목 여유0이다. M3 너트 AF5.5와 포켓도 여유0, 골반 M2.5 너트 AF5도 여유0이다.
이는 나사 길이를 정하지 못하는 이유가 아니라 실제 FDM 끼움 문제다. 먼저 해당 자리의 작은 시험 출력을 하고 끼움 보정/국부 후가공 여부를 결정해야 한다. 프린터나 필라멘트를 특정하지 않은 상태에서 무조건 손으로 들어간다고 보장할 수 없다.

참조
XL 공식 도면: https://www.robotis.com/service/download.php?no=772
XM 공식 도면: https://www.robotis.com/service/download.php?no=157
M3 원통머리: https://nederland.bossard.com/nl-nl/standaard-bevestigingsartikelen/schroeven/schroeven-met-interne-aandrijving/912000a50030012
M3 너트: https://www.accu.co.uk/hexagon-nuts/766459-NUT203M3
M3×22: https://www.accu.co.uk/metric-cap-head-screws/151948-SSC-M3-22-A4-BL
M2.5×20 낮은 접시머리: https://dibolt.co.uk/products/m2-5-x-20mm-machine-screw-countersunk-pozi-stainless-steel-a2-304-din-965/
M2.5×8 원통머리: https://nederland.bossard.com/nl-nl/standaard-bevestigingsartikelen/schroeven/schroeven-met-interne-aandrijving/912000a20025008

7. 추가 확인된 머리/삽입 길이
XL 피치 측면 캐리어의8구멍은 모두 Ø2.9, 두께4.5 mm이다(260 Faces23/24/27/28;261 Faces9/10/26/27). M2.6×8의 케이스 삽입은3.5 mm로 공식 최대4 mm 이내다.
피치 M2 원통머리 높이2 mm: 머리 받침X9에서X11까지. 무릎 실제 케이스 시작X12와1 mm 차이.
크랭크 M2 머리 받침X53.25에서55.25까지. 4개 머리 중심의Z는-77.5,-85.5,-93.5이고 외경3.8을 써도 근처 작은 캡/푸시로드와Z구간이 떨어진다.
XM 앞 기존 WB M2.5×12는 underhead X-8.8, 끝X-20.8. 새 Ø4.7 90°접시머리는 명목상 topX-4.75에 앉고14 mm 끝X-18.75이므로 기존보다2.05 mm 덜 들어간다. 공식2T+스페이서+14 mm 앞면 조립례가 해당 선택의 근거다. 끝깊이가 같아야 한다는 뜻은 아니다.

M3 너트 주변 명목 공간:
큰관절 너트범위X51.8125..54.2125, 나사끝54.9375. 작은 링크 중심은Z-57, 큰 관절은Z-85.5이므로 서로28.5 mm 떨어져 있다.
작은 모터쪽 너트57.3125..59.7125/끝61.5; 작은 종아리쪽57.1875..59.5875/끝61.8125. 해당 위치 너트외측에는 다른 고정판이 없으며0.4 mm 너트 돌출이 다른 부품에 눌리는 구조가 아니다.
종아리 중간/발 너트는X32.5375..34.9375로 깊이4 mm 포켓 안에 놓이고, 나사끝30.8125는 외측면30.9375보다0.125 mm만 나온다.
골반M2.5 너트는X50.5..52.5, 나사끝X50.0, 막힌벽49.5. 너트와 막힌벽 사이1 mm, 나사끝과벽 사이0.5 mm이다.
이 수치는 저장 자세 및 명목 치수 검토이다. 인쇄 변형, 실제 나사의 길이공차, 전동 동작에서의 접촉을 대신하지 않는다.

M2 평와셔 표준 치수 확인: Würth ISO7089 article51492, 내경2.2/외경5/두께0.3 mm. https://www.wurth.es/wsh-iso7089-200hv-a2k-2
