Leehyunbin0131/dog/docs/assembly/printing_and_assembly_KO.txt

Micro_Dog X430 확대형 — 출력·조립·하드웨어 안내
2026-10-17 UTC / 단위: mm / 중앙 몸체 제외

1. 이 파일 세트의 범위

원본 Micro_Dog의 곡선과 허니컴 형태를 기준으로 다리를 1.5배 확대하고, 모터·나사·베어링 결합부는 실제 부품 크기로 수정한 시험 조립용 설계입니다.
대퇴/푸시로드 중심거리 142.5, 크랭크 중심거리 28.5, 종아리 기준 길이 145.5입니다. 모터와 베어링은 1.5배 확대하지 않았습니다.

- 좌우 벌리기(롤): XM430-W210 4개
- 앞뒤 회전(피치) 및 무릎 구동: XL430-W250 8개
- 다리, 롤 캐리어, U자 요크, 반대편 고정 베어링 지지대까지 포함합니다.
- 중앙 몸체, 전장, 전원, 배선 길이, 제어기·보행 정책은 이번 기구 파일의 완성 범위에 포함되지 않습니다.
- 별도의 DYNAMIXEL 반대편 아이들러 혼 없이, 외부 베어링과 고정 지지대를 사용하는 구조입니다.

배포 STL은 닫힌 메시·연결성·면 방향 등을 검사했습니다. 주요 맞물림은 명목 치수와 저장된 정적 자세에서 확인했습니다. 출력 공차, 실제 체결력, 하중·피로·충격, 전 가동 범위의 충돌, 케이블 굽힘 수명은 검증되지 않았습니다. 먼저 한 다리를 시험 조립한 뒤 나머지를 출력하세요.

TPU 발은 원본의 탄성 체결 형상을 유지합니다. 원본에서 이어진 국부적인 겹침이 있어, 단단한 PLA로 무간섭 조립되는 발로 간주하면 안 됩니다. TPU 95A 시험용으로 사용합니다.

2. 좌우·앞뒤 구분과 출력 수량

로봇이 전진하는 방향을 기준으로 RR=오른쪽 뒤, FR=오른쪽 앞, LR=왼쪽 뒤, FL=왼쪽 앞입니다. LR은 다른 문서에서 RL로 표기되기도 합니다.

- 오른쪽 다리: RR 이름의 대퇴·종아리·종아리 반대판을 RR와 FR에 각각 사용합니다.
- 왼쪽 다리: LH 이름의 위 세 부품을 LR와 FL에 각각 사용합니다.
- 요크는 대각선으로 구분됩니다. RR 요크는 RR+FL, LR 요크는 LR+FR입니다.
- 크랭크, 푸시로드, 캡, 발, 두 캐리어와 고정 지지대는 공용 형상입니다. 파일명 RR만 보고 모두 오른쪽 전용이라고 판단하지 마세요.
- 앞다리 피치 모터 케이스는 뒷다리의 대응 모터와 비교해 출력축 둘레로180° 다른 방향입니다. 무릎 모터까지 함께 뒤집는 뜻은 아닙니다. 좌우 형상과 케이스 방향을 각각 확인하고, 모터 영점·혼 기준은 실물에서 맞추세요.

최종 출력 파일 18종 / 완성 4다리 기준 수량:
01. RR_XL430_thigh_finish_v2_fine005.stl ×2 — 오른쪽 대퇴
02. LH_XL430_thigh_finish_v2_fine005.stl ×2 — 왼쪽 대퇴
03. RR_shank_MR137ZZ4_fine005.stl ×2 — 오른쪽 안쪽 종아리
04. LH_shank_MR137ZZ4_fine005.stl ×2 — 왼쪽 안쪽 종아리
05. RR_shank_companion_original_shape_fine005.stl ×2 — 오른쪽 종아리 반대판
06. LH_shank_companion_fine005.stl ×2 — 왼쪽 종아리 반대판
07. RR_XL430_knee_crank_original_shape_fine005.stl ×4 — 무릎 크랭크
08. RR_pushrod_original_shape_fine005.stl ×4 — 푸시로드
09. Large_retaining_cap_MR137ZZ4_fine005.stl ×4 — 큰 베어링 고정 캡
10. Small_retaining_cap_original_fine005.stl ×8 — 작은 베어링 고정 캡
11. RR_foot_original_shape_fine005.stl ×4 — TPU 95A 발
12. XM430_roll_horn_carrier_finish_fine005.stl ×4 — 롤 혼 쪽 캐리어
13. XL430_roll_bearing_carrier_MR137ZZ4_clearance_v2_fine005.stl ×4 — 롤 베어링 쪽 캐리어
14. Pelvis_roll_support_MR137ZZ4_clearance03_fine005.stl ×4 — 고정 베어링 지지대
15. RR_XM430_pelvis_yoke_checked_fine005.stl ×2 — RR+FL 요크
16. LR_XM430_pelvis_yoke_fine005.stl ×2 — LR+FR 요크
17. XL430_keyed_spacer_reference.stl ×16 — XL 케이스용 키 형상 스페이서
18. XM430_case_spacer_reference_fine005.stl ×16 — XM 케이스용 스페이서

총 84개입니다. 이 중 스페이서 32개, 발 4개이며, 발을 제외한 80개는 PLA 기준입니다. 정품 스페이서가 있으면 해당 종류의 출력 수량을 줄일 수 있습니다. 예전 3 mm 베어링용 종아리·캡이나 clearance_v2 이전 롤 베어링 캐리어를 섞지 마세요.

3. 구매·재사용 하드웨어

2026-10-17 체결부 치수 검토 반영. 아래는 중앙 몸체를 제외한 완성 네 다리 기준이며, 여분과 모터 자체 혼 중심 고정 나사는 별도입니다. 보유 모터는 XL430-W250 8개와 XM430-W210 4개입니다.
나사 길이는 최종 CAD의 머리·너트 받침면, 모터 결합부와 제조사 도면을 대조해 선정했습니다. 명목 치수 검토이며 실제 출력 공차, 체결 토크·하중, 전 가동 범위의 충돌까지 검증했다는 뜻은 아닙니다.

베어링
- MR137ZZ, 내경7 × 외경13 × 폭4 mm: 8개. 다리 끝 큰 관절4 + 롤 지지4입니다.
- 내경6 × 외경10 × 폭2.5 mm 소형 베어링: 8개. 푸시로드 양 끝입니다. MR106 계열이라는 이름만 보고 주문하지 말고 폭2.5를 확인하세요. 폭3 제품은 이 스택과 다릅니다.

나사·너트·와셔 구매 규격과 수량
- M2×8 mm 육각렌치 원통머리, ISO 4762: 32개. 피치 혼16 + 무릎 크랭크 혼16입니다.
- M2×6 mm 육각렌치 원통머리, ISO 4762: 16개. 롤 혼용입니다.
- M2 평와셔, 내경2.2 × 외경5 × 두께0.3 mm: 16개. 위 롤 혼 M2×6마다1개씩 사용합니다.
- M2.6×8 mm 팬머리 태핑나사, ROBOTIS XL430 플라스틱 케이스에 맞는 지정 형식: 32개. 피치 모터 측면용입니다. 일반 M2.6 기계나사나 M2.5 나사로 대체하지 마세요.
- M2.5×20 mm 십자90°접시머리, DIN 965 H/ISO 7046-2 계열, 머리 외경4.7 mm 이하: 16개. 무릎 XL 뒤쪽 장착용입니다.
- M2.5×14 mm 십자90°접시머리, DIN 965 H/ISO 7046-2 계열, 머리 외경4.7 mm 이하·높이1.5 mm 이하: 16개. XM 앞쪽 요크용입니다.
- M2.5×8 mm 육각렌치 원통머리, ISO 4762: 8개. 고정 베어링 지지대–요크 연결용입니다.
- M2.5 일반 육각너트, 대변5 × 두께2 mm: 8개. 위 고정 지지대–요크 연결용입니다.
- M3×22 mm 육각렌치 원통머리, ISO 4762: 4개. 큰 다리 관절용입니다.
- M3×12 mm 육각렌치 원통머리, ISO 4762: 4개. 푸시로드의 모터쪽 작은 관절용입니다.
- M3×14 mm 육각렌치 원통머리, ISO 4762: 4개. 푸시로드의 종아리쪽 작은 관절용입니다.
- M3×18 mm 육각렌치 원통머리, ISO 4762: 12개. 종아리 중간 체결8 + 발 체결4입니다.
- M3 일반 육각너트, DIN 934, 대변5.5 × 두께2.4 mm: 24개.

총 나사144개, 너트32개, 롤 혼용 평와셔16개입니다. M3 위치와 고정 지지대–요크 M2.5 위치는 와셔를 넣지 않는 길이로 선정했습니다. 일반 M3 평와셔는 기존 머리 포켓보다 외경이 커서 임의로 추가할 수 없습니다. 원통머리와 둥근 버튼머리는 외경·높이가 다르므로 같은 것으로 주문하지 마세요.

기존 안내의 ‘M3 32곳’ 표기를 정정합니다. 다리 관절·종아리·발은 M3 24곳이고, 고정 지지대–요크는 M2.5 8곳입니다. 후자의 원본부터 이어진 머리 포켓은 지름5, 너트 자리는 대변5이므로 일반 M3 머리·너트가 들어가지 않습니다. M2.5×8과 위 너트가 명목 형상에 맞습니다. 해당 이유만으로 출력 형상을 변경해야 하는 것은 아닙니다.

주요 길이·자리 확인
- M2 혼 연결 출력물 두께는 피치6, 크랭크5.25, 롤4 mm입니다. 선정 나사의 명목 삽입은 피치2, 크랭크2.75, 롤1.7 mm(0.3 mm 와셔 포함)입니다. XL 혼 최대3.5, XM 혼 최대2 mm 이내로 선정했습니다. 롤 와셔를 빼면 최대깊이에 도달하므로 생략하지 마세요.
- XL 혼에는 M2 나사구멍4개와 지름1.7 평구멍4개가 번갈아 있습니다. 출력물은 M2 나사구멍 쪽에 맞춥니다.
- 피치 측면 캐리어 두께는4.5 mm이므로 M2.6×8의 케이스 삽입은3.5 mm입니다. 제조사 지정 태핑나사 형식을 사용합니다.
- 무릎 뒤쪽 M2.5×20은 지정90°·외경4.7 접시머리일 때 기존 나사 끝보다 명목0.25 mm 덜 들어갑니다. XM 앞쪽 M2.5×14도 기존 나사 끝보다 덜 들어가며 제조사 앞면 조립례와 대조했습니다. 실제 구멍바닥 깊이를 직접 확인한 값은 아니므로 구매품의 머리·길이 공차와 출력 치수를 확인하세요.
- M3 머리 받침면–너트 받침면 간격은 큰 관절18.875, 작은 모터쪽7.8125, 작은 종아리쪽9.375, 종아리 중간/발13.875 mm입니다. 선정 길이는 너트 전체 두께를 지나도록 정했습니다.
- 고정 지지대–요크는 받침면 간격5.5 mm입니다. M2.5×8은 명목상 너트 밖으로0.5 mm 나오고 막힌 뒤쪽 벽까지0.5 mm 남습니다. 너트는 주변 부품을 닫기 전에 측면에서 넣습니다.

출력 끼움 공차
다리의 M3 머리 포켓 지름5.5와 너트 자리 대변5.5, 골반의 M2.5 너트 자리 대변5는 표준 체결품 최대 치수와 명목상 같습니다. 자동으로 FDM 끼움 여유가 들어간 자리가 아니므로 먼저 시험 출력하여 확인하고, 필요하면 해당 자리만 공차 보정이나 후가공을 하세요. 나사 조임력으로 머리나 너트를 억지로 밀어 넣지 마세요. 일부 머리·너트는 포켓보다 높아서 바깥으로 조금 나오며, 돌출 자체가 잘못된 조립은 아닙니다.

스페이서와 보유품 재사용
- XL 키 스페이서: 무릎 모터 뒤쪽4개씩, 합계16개. 피치 모터 측면용이 아닙니다.
- XM 케이스 스페이서: 롤 모터 앞쪽 요크4개씩, 합계16개.
- 두 종류는 출력 파일에 포함되어 별도 구매가 필요하지 않습니다. 정품을 보유했다면 해당 출력물을 대신할 수 있습니다. 형상·높이가 달라 서로 바꿔 쓸 수 없습니다. 먼저 각1개씩 시험합니다.
- 출력 혼12개와 혼 중심 고정나사12개, 모터 케이블은 보유 모터 부속품에서 확인하고 재사용하세요. 보유 여부를 확인하기 전에는 모두 추가 구매품으로 세지 않습니다. 중앙 전장 배치와 케이블 길이는 이 기구 범위에서 정해지지 않았습니다.
- 별도 DYNAMIXEL 반대편 아이들러 혼은 사용하지 않습니다.

접시머리의 표기 길이는 머리를 포함합니다. 원통머리·팬머리 나사는 머리 아래부터 잽니다. 나사가 구멍 바닥에 닿기 전에 부품을 정상적으로 눌러 고정해야 하며, 플라스틱 케이스를 억지로 조여 맞추면 안 됩니다.

4. 출력 방향과 서포트

STL 단위는 mm, 배율100%입니다. 이미 확대된 파일이므로 슬라이서에서 다시1.5배 하지 마세요. 0.4 mm 노즐의 PLA 프로파일을 기준으로 시작하고, 실제 프린터의 구멍·축 치수를 먼저 확인합니다. 아래 X/Y/Z는 개별 부품 파일의 좌표입니다. 슬라이서의 ‘면을 바닥에 놓기’를 사용하면 편합니다.

- 대퇴 RR/LH: 긴 허니컴 팔의 바깥 평면 X=44.625를 바닥으로 놓고, −X 방향으로 쌓습니다. 근위 모터 장착판과 내부 천장, 큰 베어링 보스의 얕은 단차에는 서포트가 필요할 수 있습니다. 베어링 구멍·케이블 통로·나사 자리를 서포트로 막지 않도록 미리 확인하세요. 이 부품을 무서포트 출력물로 간주하지 마세요.
- 안쪽 종아리 RR/LH: 넓은 X=−1.5 면을 바닥에 놓고 +X 방향으로 쌓습니다. 큰 베어링 반축은 위를 향합니다. 바닥 쪽 육각 너트 자리의 작은 천장과 발 체결부 브리지를 확인합니다.
- 종아리 반대판 RR/LH: 넓은 X=−1.5 면을 바닥에 놓고 +X 방향으로 쌓습니다. 작은 반축은 위를 향합니다. 큰 캡 자리의 깊이0.6875 오목부는 슬라이서에서 국부 서포트 여부를 확인합니다.
- 크랭크: 평평한 뒤쪽 X=−1.5를 바닥, +X를 위로 놓습니다. 작은 반축이 위를 향합니다. 혼 접촉면 X=0은 바닥보다1.5 높으므로, 혼 자리 안쪽 천장에 필요한 서포트를 확인합니다.
- 푸시로드: 넓은 X=0 또는 X=6 면을 바닥에 놓습니다. 양 끝에1 mm 깊이의 얕은 자리와 지름10 구멍이 있습니다. 오목부의 좁은 천장만 필요한 만큼 지지합니다.
- 큰 캡: 평평한 플랜지 뒤쪽 X=−1.8을 바닥, 지름7 반축을 위로 놓습니다.
- 작은 캡: 넓은 뒤쪽 X=3을 바닥, −X 방향의 지름6 반축을 위로 놓습니다. 너트 자리의 천장을 확인합니다.
- 롤 혼 캐리어: 넓은 혼 접촉면 X=−4를 바닥, +X를 위로 놓습니다. 양쪽 벽은 위로 세워집니다. 벽의 가로 방향 나사 구멍에 브리지·국부 서포트가 필요한지 확인합니다.
- 롤 베어링 캐리어: 베어링 링 입구 X=−5를 바닥, +X를 위로 놓습니다. 넓은 판 X=−4는 바닥에서1 mm 떠 있으므로 링 바깥 판 아래에 서포트가 필요합니다. 지름13.15 자리와 안쪽 어깨 면이 거칠어지지 않게 서포트를 제거합니다.
- 고정 지지대: 넓은 외측 평면 X=6을 바닥, −X 방향의 지름7 축을 위로 놓습니다. 축 끝을 바닥에 세우지 마세요.
- RR 요크: 긴 레일의 넓은 평면 Z=−21을 바닥에 놓습니다. LR 요크는 대칭인 Z=+21 면을 바닥에 놓습니다. 레일은 눕고 앞·뒤 벽은 섭니다. 가로 방향 혼 구멍과 나사 구멍을 확인하고, 얇은1.5 mm 앞 플랜지의 접시 자리를 서포트 제거 중 손상시키지 마세요.
- XL 스페이서: 넓은 평면 Z=17 쪽을 바닥으로 뒤집어 놓습니다. 키·턱이 위를 향하도록 하고 바닥에 자동으로 내립니다. 원래 파일은 원점에서 떨어져 있습니다.
- XM 스페이서: 저장된 방향의 평면 Z=0을 바닥으로 놓습니다. 높이2.8입니다.
- TPU 발: 측면의 평평한 테두리 X=1.5 또는 X=15.75를 바닥에 놓는 방향이 출발점입니다. 접지 곡면을 억지로 평평하게 깎지 마세요. 접지 면적이 작으므로 브림을 고려하고, 내부 결합부의 TPU 브리지와 제거 가능한 서포트를 먼저 시험합니다.

베드에 닿은 정밀 면은 첫 층 퍼짐을 확인하세요. 전체 배율을 바꿔 구멍 하나를 맞추면 링크 길이와 나사 간격도 바뀝니다. 필요하면 해당 자리만 후가공하거나 슬라이서의 국부 보정을 사용하되, 베어링 축·어깨 면을 무작정 깎지 마세요.

5. 첫 시험과 조립 순서

1) 먼저 XL/XM 스페이서 각1개, 큰 캡1개, 작은 캡1개를 출력해 실제 모터·베어링과 맞춰 봅니다. 그 다음 RR 한 다리와 해당 골반 모듈을 시험합니다. 끼움이 지나치게 빡빡하면 조임력으로 밀어 넣지 않습니다.
2) 전원을 끈 상태에서 케이블 동선을 잡습니다. 무릎 모터 옆창과 대퇴의 뒤쪽 케이블 홈으로 케이블을 먼저 통과시키고 플러그를 꽂습니다. 요크·캐리어를 닫은 후에는 플러그나 드라이버가 지나가지 못할 수 있습니다. 케이블을 접합면이나 나사 아래에 끼우지 마세요.
3) 무릎 XL 뒤쪽의 네 파인 자리에 XL 스페이서를 넣고 대퇴 장착판에 고정합니다. 평면 장착판과 스페이서가 함께 압력을 받도록 합니다. 실제 접시머리 안착과 나사 길이를 먼저 확인합니다.
4) 피치 XL은 두 롤 캐리어 사이에 놓고 지정 측면 나사로 고정합니다. 혼의 기준 표시와 모터의 기준 위치를 확인한 다음 대퇴와 무릎 크랭크를 연결합니다. 혼 중심 고정 나사는 모터 제조사의 조립법을 따릅니다.
5) 큰 베어링7×13×4를 대퇴 끝 자리에 넣고, 안쪽 종아리의 지름7 반축과 큰 캡을 양쪽에서 결합합니다. 수정된 반축과 캡은4 mm 베어링용입니다. 베어링 외륜을 억지로 끌어당기는 방식으로 볼트를 조이지 마세요.
6) 작은 베어링6×10×2.5 두 개를 푸시로드 양 끝에 넣습니다. 크랭크의 작은 축과 반대판의 작은 축에 연결하고 작은 캡을 각각 장착합니다. 큰 캡과 작은 캡을 혼용하지 마세요.
7) 종아리 두 판의 중간 체결부를 맞추고 TPU 발을 발끝 결합부에 넣습니다. TPU 결합부를 조금씩 변형해 맞추되, PLA 판이 휘도록 강제로 끼우지 않습니다. 발의 조임 상태와 미끄러짐은 실물에서 확인합니다.
8) 골반은 XM 앞쪽 네 스페이서와 U자 요크를 먼저 체결합니다. 지정된 낮은 접시머리 나사를 사용합니다. 움직이는 혼 캐리어를 먼저 달면 일부 나사에 드라이버가 접근하기 어려워집니다.
9) 요크 끝에 고정 베어링 지지대를 연결합니다. 롤 베어링 캐리어의 지름13.15·깊이4 자리에는 MR137ZZ를 넣고, 고정 지지대의 지름7 축과 맞춥니다. 혼 쪽 캐리어를 XM 출력 혼에 연결하여 롤 모듈을 닫습니다.
10) 전원을 넣기 전 각 관절을 천천히 움직여 베어링의 뻑뻑함, 나사 끝 접촉, 케이블 눌림을 확인합니다. 실제 구동 시험은 모듈을 안전하게 고정하고 작은 동작부터 시작합니다. 원본 XL330 로봇의 관절 제한·전원 구성·보행 정책을 그대로 적용할 수 있다고 가정하지 마세요.

베어링을 자리에 넣을 때는 끼워 넣는 링에만 힘을 가하세요. 축에 끼울 때는 내륜, 하우징에 넣을 때는 외륜을 지지하여 볼을 통해 압력을 전달하지 않도록 합니다. 조인 뒤에도 회전이 부드러운지 확인합니다.

6. 중앙 몸체 연결을 위한 기구 기준

롤 지지의 하중 경로는 ‘XM 앞 케이스 → 고정 U자 요크 → 고정 지지축 → 외부 롤 베어링 → 움직이는 베어링 캐리어’입니다. 고정 지지대의 밑부분은 요크에 붙습니다. 이를 중앙 몸체에 직접 고정하는 별도 지지대로 해석하지 마세요.

새 중앙 몸체의 롤 모터 체결부는 XM430 기준으로 설계해야 합니다. 기존 몸체의16×30 구멍 간격과 새 XM의22×40 구멍 간격은 다릅니다. 구멍만 늘려도 케이스 뒤쪽 공간이 자동으로 확보되는 것은 아닙니다.

CAD의 롤 혼 캐리어 좌표 H를 기준으로:
- 롤 축 중심: H_Y=−11.5, H_Z=−10
- 움직이는 혼 접촉면: H_X=−4
- XM 앞 케이스 면: H_X=−6
- 요크 앞 플랜지: H_X=−6..−4.5, 명목 두께1.5
- XM 뒤쪽 명목 체결면: H_X=−40, 전체 참고 형상의 뒤쪽 돌출은 H_X=−42까지
- 기존 XL330 몸체 체결 기준면은 H_X=−30이므로, 모터 뒤쪽 공간과 체결면 모두 다시 정해야 합니다.
- 롤 베어링 캐리어 자체 좌표: 지름13.15 자리 X=−5..−1, 깊이4. 안쪽 어깨 X=−1..0, 통과 구멍 지름7.5.
- 고정 지지대: 지름7 축의 직선 구간 X=−4.125..+0.125, 뿌리 R0.5, 끝 모따기0.25. 캐리어 외측 링과 지지대 홈의 명목 반경 여유0.30.

중앙 몸체의 최종 폭·길이·장착판 두께는 정해지지 않았습니다. 조립 참고 모델의 네 다리 배치를 그대로 기존 몸체에 볼트로 고정할 수 있다는 뜻은 아닙니다. 몸체 설계 시 실제 커넥터, 나사 접근, 전장, 다리 가동 범위를 함께 확보하세요.

4다리 출력물 전체보기는 중앙 몸체와 모터를 생략한 배치 참고용입니다. 앞·뒤 모듈을 원본 몸체 기준에서 각각 바깥쪽으로16.5 이동한 참고 간격을 사용하며, 확정된 새 몸체 규격이나 전 가동 범위의 여유를 의미하지 않습니다. 모터를 포함한 RR 단일 모듈과 구분해서 보세요. 전체보기에는 작은 스페이서와 체결 하드웨어가 모두 표시되는 것은 아닙니다.

7. 원본과 라이선스

원본: Micro_Dog, © 2026 moieboy9999
https://github.com/moieboy9999/Micro_Dog
이 수정본은 저장소의 step/micro_dog.step 기반입니다. 저장소 설명상 해당 STEP은2026-08-23 내보내기이며, 더 최신 Inventor 원본의 발·몸체 커버 변경까지 포함한다고 가정하지 않습니다.

변경 내용: 다리 외형1.5배 확대, XM430/XL430 결합부 수정, 실제 크기 나사·베어링 자리 복원, 7×13×4 베어링 축방향 스택, 케이블 통로, 골반 지지·요크, 좌우 대칭 부품, 대퇴 표면 마감.

원본 기구 설계와 이를 바탕으로 수정한 출력 부품은 CC BY-NC-SA 4.0 조건을 따릅니다. 저작자·출처와 변경 사실을 표시하고, 비영리 조건 및 동일조건변경허락을 지켜 재배포하세요.
원본 라이선스: https://github.com/moieboy9999/Micro_Dog/blob/main/LICENSE
라이선스 설명: https://creativecommons.org/licenses/by-nc-sa/4.0/deed.ko
제3자 저작물 안내: https://github.com/moieboy9999/Micro_Dog/blob/main/ATTRIBUTION.md

DYNAMIXEL 모터·혼·스페이서 참고 형상은 ROBOTIS 공식 CAD에 기반하며 ROBOTIS의 저작물입니다. Micro_Dog의 자체 설계 저작물로 표시하거나, 위 라이선스가 제3자 CAD의 권리까지 바꾸는 것으로 해석하지 마세요.

모터 도면·조립 주의사항:
https://emanual.robotis.com/docs/en/dxl/x/xl430-w250/
https://emanual.robotis.com/docs/en/dxl/x/xm430-w210/
XM 앞쪽 접시머리 조립 예시:
https://emanual.robotis.com/assets/images/dxl/x/assembly/x430/x430_etc_assembly_example_front2_02.png
작은 머리 M2.5×14 제품 치수 확인 예시(구매품 실측 필요):
https://www.accu.co.uk/phillips-countersunk-screws/66053-SIK-M2-5-14-A4
