Leehyunbin0131/dog/docs/assembly/assembly_access_review.txt

Micro_Dog X430 — 조립 순서·공구 접근 검토
2026-10-17 UTC. 최종 FCStd 읽기 전용 확인; 모델 변경 없음.

검토 범위와 한계
기존 출력 안내와 체결부 치수 감사, RR_complete_leg_pelvis_final.FCStd의 저장 자세를 검토했다.
명목 형상 및 직선 공구축 검토이며 실제 드라이버 손잡이, 출력 공차, 회전 경로 전체, 케이블 가동 범위, 실물 체결 검증이 아니다.

핵심 접근 함정
1. 롤 혼 나사는 피치 모터를 넣기 전에 조인다.
   롤 M2×6 머리+0.3 와셔는 X=0..2.3, 피치 케이스는 X>=3.5이다.
   저장 자세의 롤 혼 나사축 일부가 피치 모터 실제 형상을 통과한다.
   XM 앞 스페이서+요크 → 조립된 XM 혼에 빈 롤 혼 캐리어 체결 → 피치 모터 삽입 순서가 적절하다.
   XM 출력 혼과 중심 고정나사를 분리하는 폭발도로 표현하지 않는다.

2. 피치 혼–대퇴는 무릎 모터와 링크를 붙이기 전에 체결한다.
   피치 M2×8 머리 범위 X=9..11, 무릎 케이스 시작 X=12로 좁다.
   모터 참고 CAD는 내부의 실제 부품 전부를 나타내지 않는다. 빈 참고 공간을 공구 통로로 보장하면 안 된다.

3. 무릎 뒤쪽 M2.5×20 아래 두 개는 저장 자세에서 피치 케이스에 가린다.
   RR 다리 좌표: Y=±11,Z=-93.5, 머리 쪽 X=4.1에서 -X로 접근.
   Y=-11 축과 피치 모터 교차: X=-8.95..-2.05 및 -29.95..-11.05, 총25.8 mm.
   Y=+11 축과 피치 모터 교차: X=-28.25..1 및 -33..-31.9, 총30.35 mm.
   위쪽 두 축 Z=-53.5은 직선 중심선 기준으로 비어 있다.

   시험할 후보 절차:
   골반 캐리어와 링크를 붙이기 전, 피치 XL+맨 대퇴를 독립된 상태로 준비한다.
   케이블을 먼저 통과시키고 무릎 XL의 스페이서와 뒤쪽 나사를 설치한다.
   아래 나사 각각을 조일 때 피치 케이스–대퇴 상대각을 잠시 바꾸어 짧은 케이스 쪽 밖으로 노출한다.
   각 나사축 반경은 sqrt(11²+8²)=13.60147이다.
   축을 Y=-13.60147,Z=-85.5로 두면 피치 모터 전체 최소Y=-11.25보다2.35147 mm 밖이다.
   지름3 mm 직선 드라이버 축은 이 모터 외곽 상자로부터 명목0.85147 mm 벗어난다.
   두 아래 나사는 같은 상대각에서 동시에 노출되지 않는다. 각각 다른 상대각에서 조인 후 기준 표시로 복귀한다.
   이 수치는 모터와 드라이버 축의 여유만 뜻한다. 손잡이 공간·중간 회전 경로·실물 작동은 확인해야 한다.
   감속기를 억지로 돌리거나 나사 조임력으로 부품을 끌어 맞추지 않는다.

4. 크랭크의 푸시로드용 M3×12 머리는 모터 쪽이다.
   크랭크를 무릎 혼에 고정하기 전에 작은 베어링+푸시로드+작은 캡+M3 체결을 준비한다.

5. 고정 지지대–요크 M2.5 너트 두 개는 측면에서 미리 넣는다.
   마지막에는 베어링 캐리어의 MR137ZZ에 고정 지지축을 넣고 지지대–요크를 닫는다.
   요크 지지대 위치는 M3가 아니라 M2.5×8 두 개+대변5/두께2 너트 두 개이며 와셔 없음.

권장 전체 묶음 순서
A. 피치 XL+대퇴 → 케이블 선통과 → 무릎 XL+스페이서(상대각 임시 변경으로 접근 확보) → 기준 표시 복귀.
B. 크랭크+작은 관절 선조립 → 무릎 혼에 크랭크 → 큰 관절/종아리/푸시로드/발 연결.
C. 별도로 XM+앞 스페이서+요크 → 조립된 XM 혼에 빈 혼 캐리어+M2×6/0.3 와셔 네 세트.
D. 완성한 피치 모터/다리를 혼 캐리어에 넣음 → 반대쪽 베어링 캐리어 → MR137ZZ+고정 지지대 → 요크 닫기.
E. 무전원 천천히 확인, 케이블 눌림/나사 끝/베어링 뻑뻑함 확인 후 안전하게 고정하여 작은 동작부터 시험.

도판 표시 권장
- 모든 해당 도판에 ‘RR 기준’ 및 모터 혼 쪽/케이스 쪽 표시. 좌우 화면 위치만으로 방향을 설명하지 않는다.
- 새 부품 주황, 기존 조립물 연회색, 모터 진회색, 베어링 청록, 체결품 파랑 등으로 일관되게 표시한다.
- 실제 케이블 CAD가 없으면 자홍 점선은 ‘배선 경로 예시, 길이·굽힘 미검증’으로 표시한다.
- 각 폭발도는 실제 삽입축을 따른다. 가려서 생략한 부품은 ‘이해를 위해 숨김’이라고 쓴다.
- XM 케이스/혼은 조립된 한 덩어리로 유지한다. 기존 케이스 체결나사 교체와 혼 분해를 혼동시키지 않는다.
- 한 단계 수량은 ‘다리1개 기준’; 전체 구매수량은 별도로 ‘4다리 기준’이라고 반복 표시한다.
- 좌우 대퇴·종아리·반대판: RR/FR은 RR, LR/FL은 LH. 요크는 RR/FL에 RR형, LR/FR에 LR형이다.
- 앞다리는 피치 모터 케이스만 대응 뒷다리 대비 출력축 둘레180° 방향 차이. 무릎 모터도 함께 뒤집는 뜻이 아니다.

수량 교차 확인: 다리1개당 나사36, 너트8(M3×6 + M2.5×2), 롤 와셔4, 큰 베어링2, 작은 베어링2.
네 다리는 나사144, 너트32, 롤 와셔16, 큰 베어링8, 작은 베어링8이다.

2026-10-17 추가 검증: 임시 피치 케이스 각도
- 출력 혼과 대퇴는 고정, 피치 케이스만 L=(0,0,-85.5)를 지나는 +X축으로 회전한다.
- Y=-11,Z=-93.5 나사: +36.027373385°.
- Y=+11,Z=-93.5 나사: +143.972626615°.
- 무릎 쪽(+X)에서 피치 모터를 바라보고 화면 오른쪽=+Y, 위=+Z일 때 각각 아래 왼쪽/오른쪽 나사에 반시계 약36°/144°이다.
- 이 각도는 저장 CAD 자세에 대한 조립 중 상대각이며 서보 제어 명령각이 아니다.
- 실제 모터 참고 CAD의 전면 케이스면 X=1.0을 기준으로 표시용 복사본을 나눠 케이스만 회전했다. X>1.00001의 혼/중심돌출부는 고정했다. 원본 변경 없음.

두 자세의 정확한 BRep 검사 결과
- 지름3, X=-60..4.35 직선 드라이버 축의 교차체적은 회전케이스/고정혼/대퇴/무릎 모두0.
- 최소거리: 케이스0.8514705, 고정혼1.8514705, 대퇴0.6010408, 무릎7.6506536 mm.
- 회전케이스–대퇴 최소거리 약1.99999, 회전케이스–무릎 약11.00000 mm. 두 경우 모두 교차0.
- 케이스X최대1.00001, 대퇴X최소2.99327245, 무릎X최소12이므로 X축 둘레 모든 회전각에 대해 케이스–대퇴1.99326245, 케이스–무릎10.99999 mm의 축방향 분리가 유지된다.
- 이 회전경로 검사는 골반/캐리어/크랭크/푸시로드/종아리를 붙이기 전 단계의 표시용 CAD에 적용한다. 배선·실제 기어 회전 저항·출력 공차·십자 비트 및 손잡이 형태는 미검증이다.

반드시 추가할 순서 수정: 긴 나사 선삽입
- 지름4.7 머리를 길이20 나사와 함께 나중에 끼우는 이동 경로는 케이스와 최소0.0014705 mm밖에 남지 않는다. 사실상 실물 삽입여유로 쓸 수 없다.
- 무릎용 M2.5×20 네 개를 대퇴에 먼저 끼워 머리를 접시자리에 느슨하게 앉혀 둔 다음 피치 혼–대퇴를 연결한다.
- 무릎 모터/스페이서를 손으로 지지하고 네 나사끝을 구멍에 맞춰 조금씩 번갈아 건다. 임시 상대각은 미리 끼운 나사를 조이는 공구 접근에 사용한다.
- 머리 상면X=4.35을 유지하면 나사 전체는X>=4.35이고 회전케이스는X<=1.00001이므로 모든 회전각에서 최소3.34999 mm 축방향 분리. 각도 변경을 위해 나사를 뒤로 뺄 필요가 없다.
- 머리를 피치 케이스 공간으로 되빼는 작업은 이 검증에 포함하지 않았다. 나사로 어긋난 부품을 억지로 당겨 맞추지 않는다.
- 길이20은 접시머리 포함. 명목 나사끝X=24.35, 원래 나사끝X=24.6보다0.25 mm 짧다. 실제 구멍바닥 깊이 검증값은 아니다.

파생 자료
hardware_audit/pitch_access_transforms.json: 정확한 각도, 행렬, 검사 수치, 조립 단계·한계.
tmp/pdfs/pitch_access_meshes.json: RR L좌표의 case_plus36, case_plus144, 고정혼, 모터 합성 메시, 각 공구축 메시.
