Leehyunbin0131/dog/docs/assembly/manual_v2/assets/access_36.png

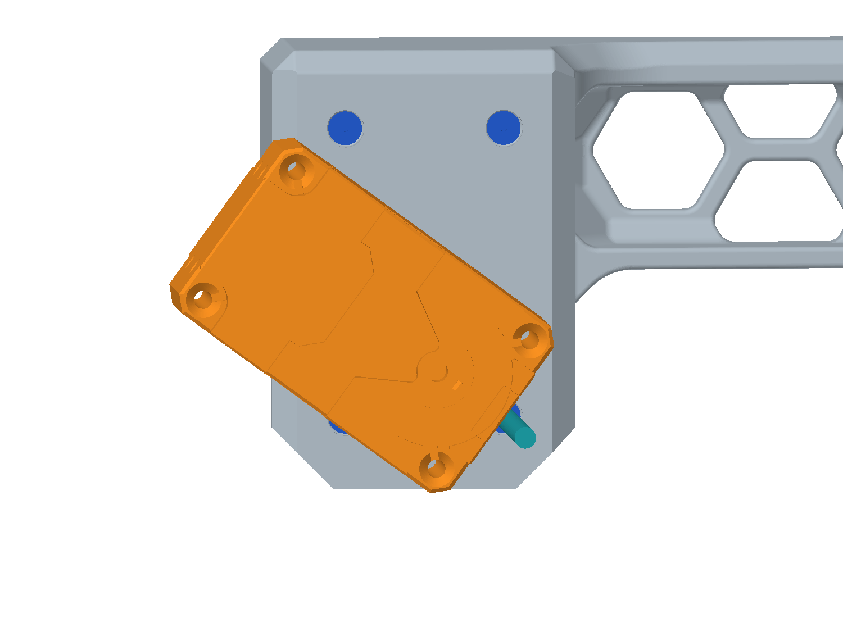
docs/assembly/manual_v2/assets/access_36.png
