Leehyunbin0131/dog/docs/assembly/manual_v2/assets/access_36_full.png

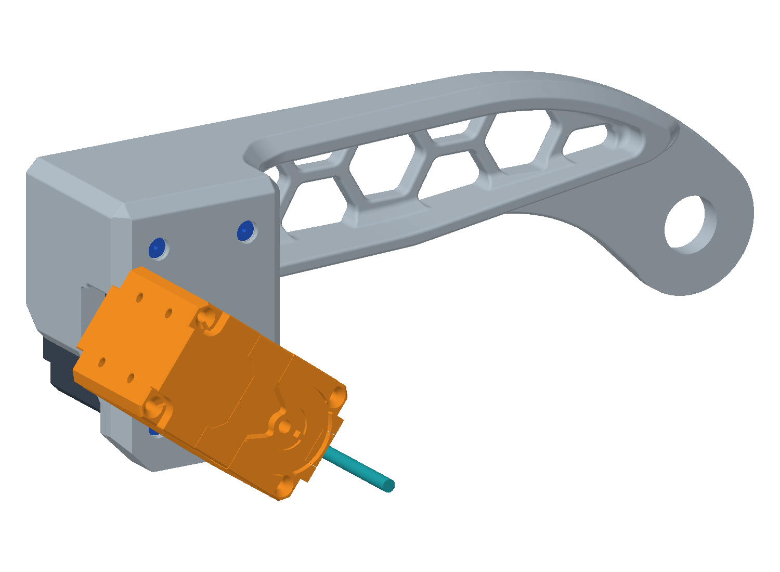
docs/assembly/manual_v2/assets/access_36_full.png
