Leehyunbin0131/dog/docs/assembly/manual_v2/assets/access_144.png

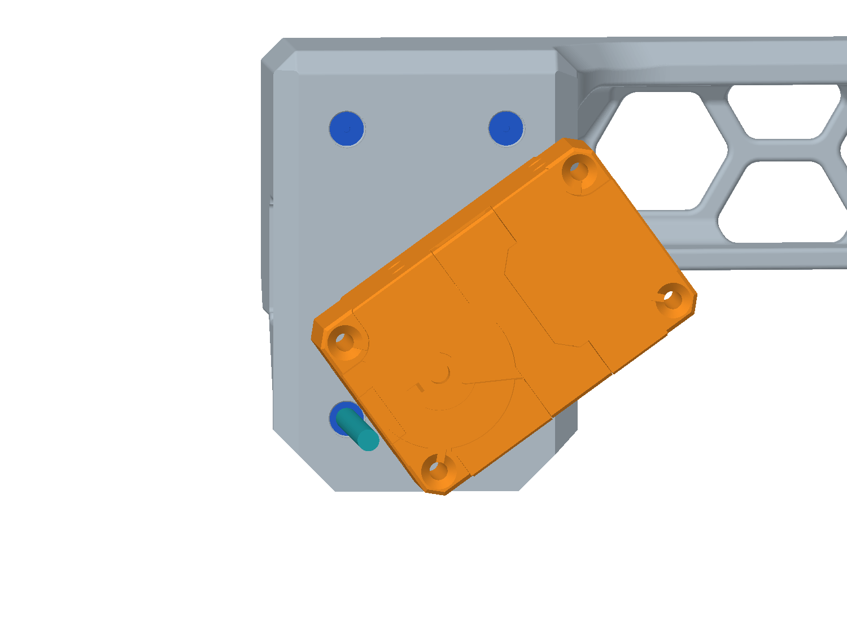
docs/assembly/manual_v2/assets/access_144.png
