Leehyunbin0131/dog/docs/assembly/manual_v2/assets/cables.png

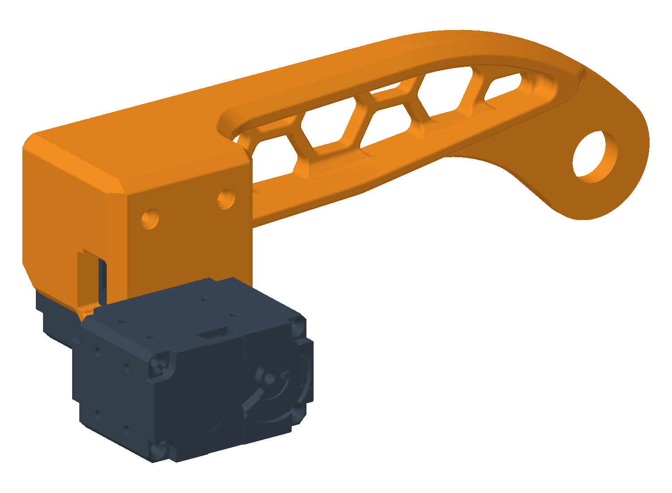
docs/assembly/manual_v2/assets/cables.png
