Leehyunbin0131/dog/docs/assembly/manual_v2/assets/carriers_a.png

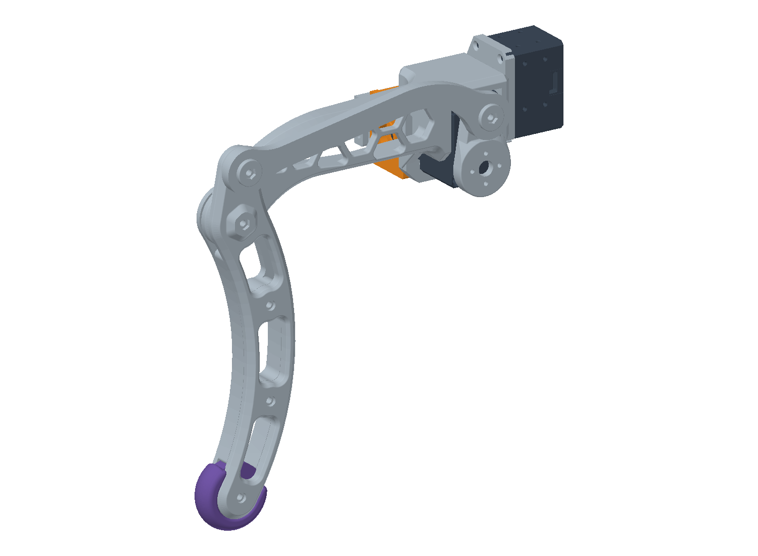
docs/assembly/manual_v2/assets/carriers_a.png
