Leehyunbin0131/dog/docs/assembly/manual_v2/assets/carriers_e.png

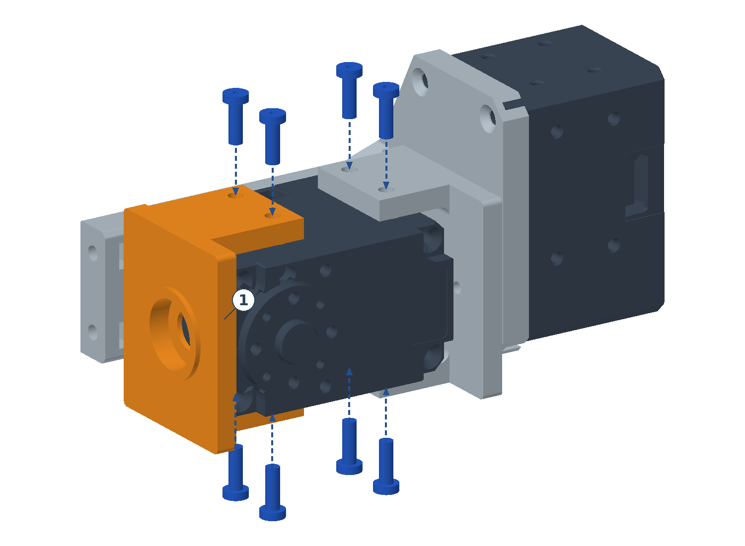
docs/assembly/manual_v2/assets/carriers_e.png
