Leehyunbin0131/dog/docs/assembly/manual_v2/assets/crank_e.png

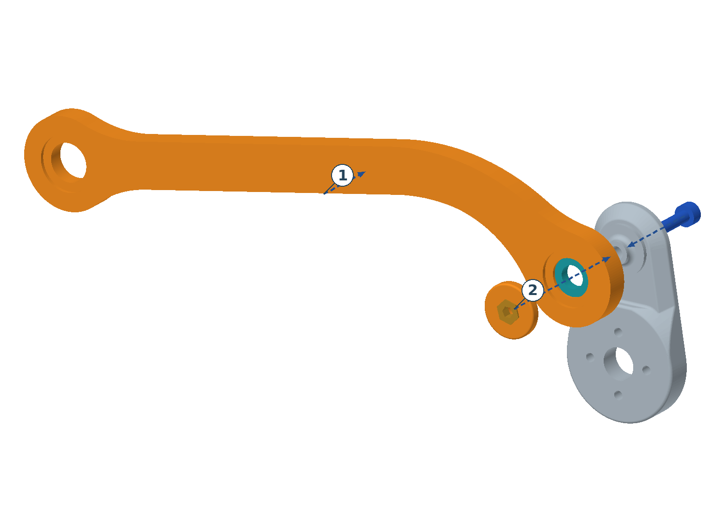
docs/assembly/manual_v2/assets/crank_e.png
