Leehyunbin0131/dog/docs/assembly/manual_v2/assets/crank_horn_a.png

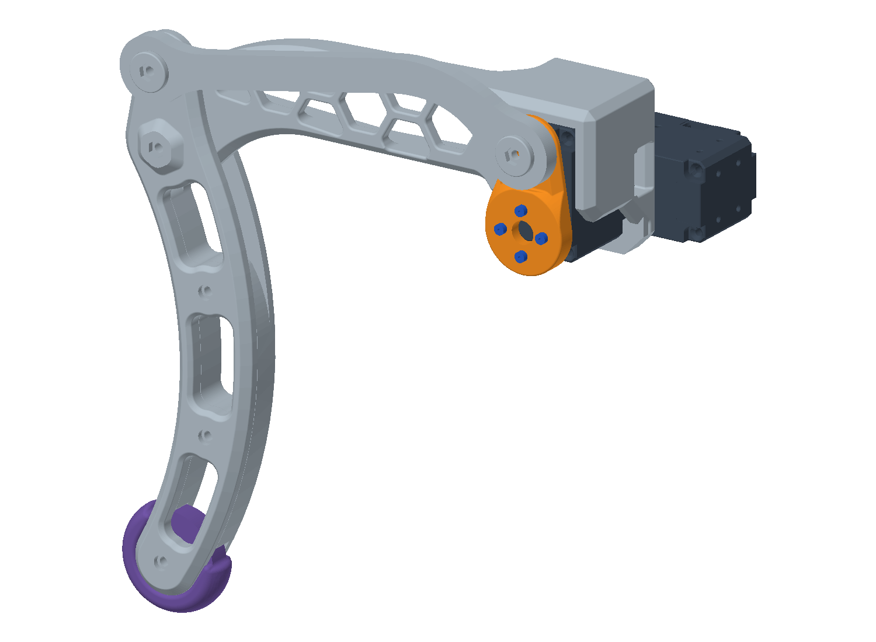
docs/assembly/manual_v2/assets/crank_horn_a.png
