Leehyunbin0131/dog/docs/assembly/manual_v2/assets/four_corner_motors.png

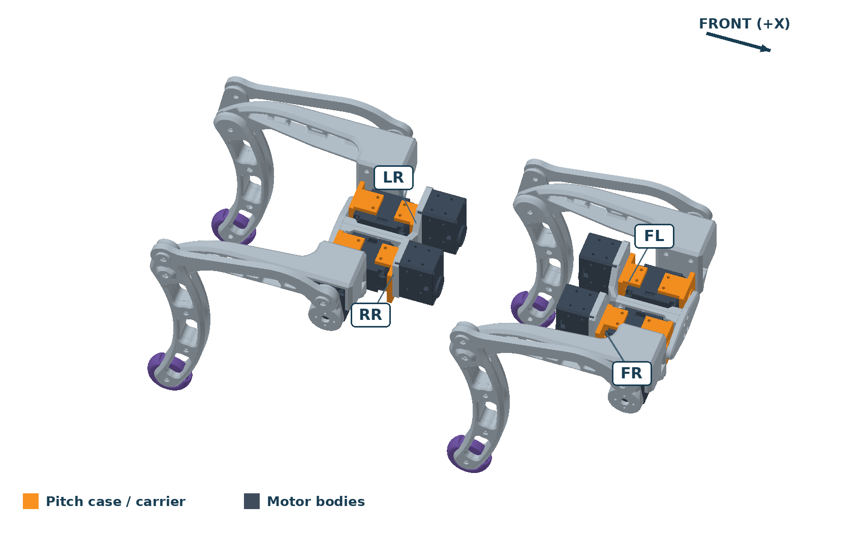
docs/assembly/manual_v2/assets/four_corner_motors.png
