Leehyunbin0131/dog/docs/assembly/manual_v2/assets/four_corner_pitch_top.png

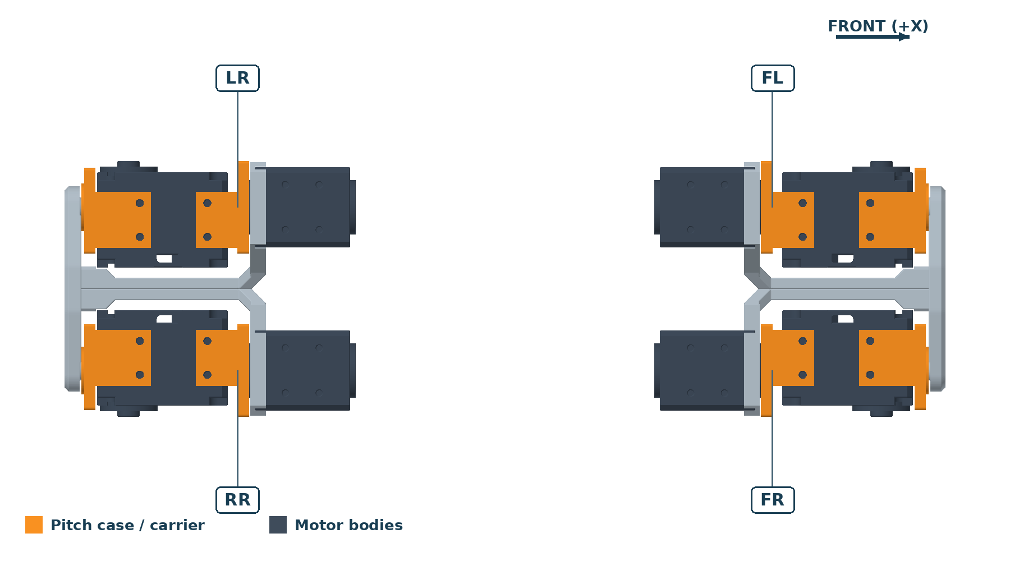
docs/assembly/manual_v2/assets/four_corner_pitch_top.png
