Leehyunbin0131/dog/docs/assembly/manual_v2/assets/knee_a.png

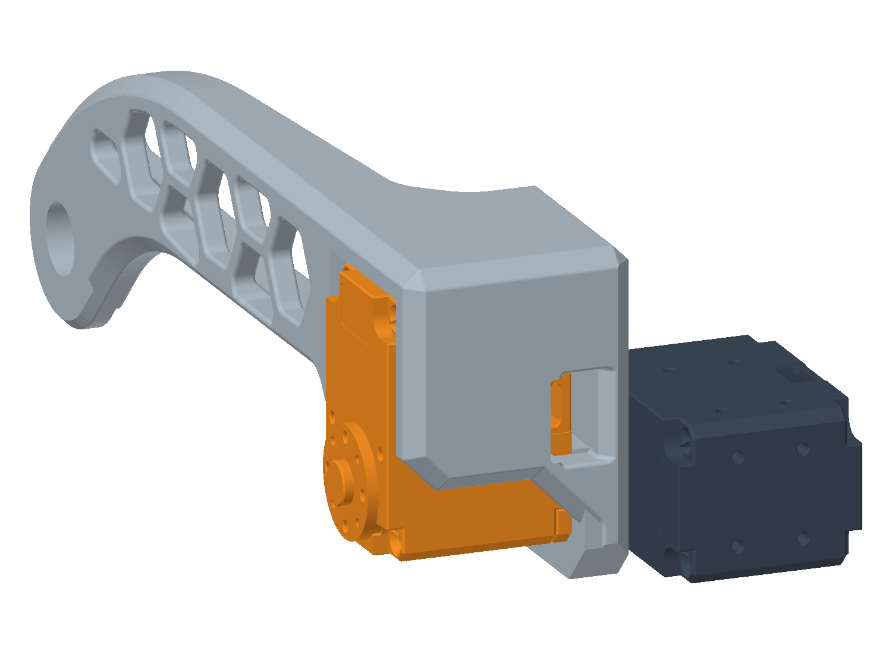
docs/assembly/manual_v2/assets/knee_a.png
