Leehyunbin0131/dog/docs/assembly/manual_v2/assets/nuts_inner.png

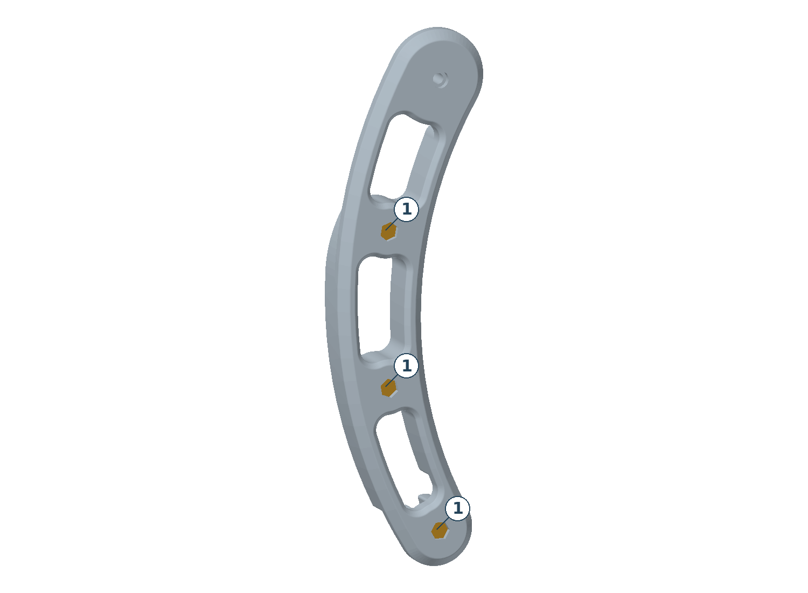
docs/assembly/manual_v2/assets/nuts_inner.png
