Leehyunbin0131/dog/docs/assembly/manual_v2/assets/nuts_leg.png

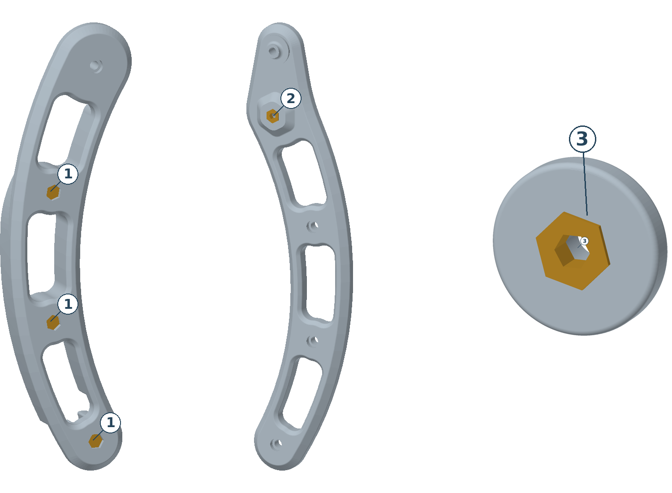
docs/assembly/manual_v2/assets/nuts_leg.png
