Leehyunbin0131/dog/docs/assembly/manual_v2/assets/pitch_e.png

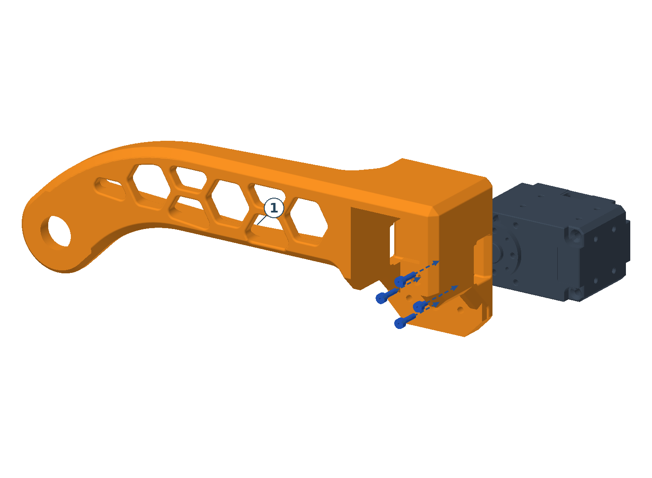
docs/assembly/manual_v2/assets/pitch_e.png
