Leehyunbin0131/dog/docs/assembly/manual_v2/assets/roll_a.png

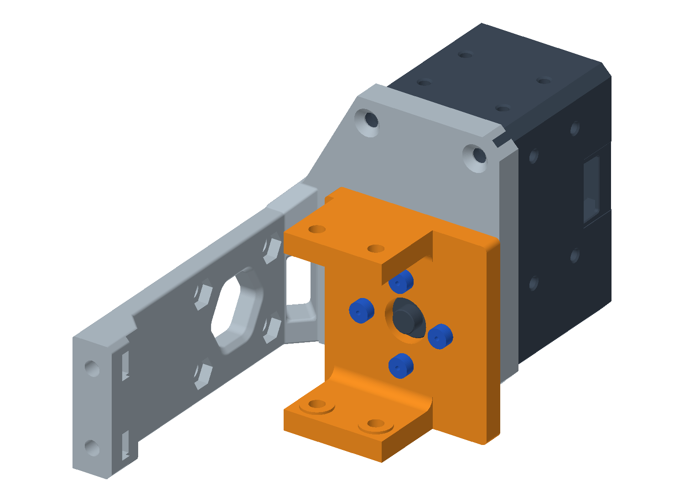
docs/assembly/manual_v2/assets/roll_a.png
