Leehyunbin0131/dog/docs/assembly/manual_v2/assets/shank_a.png

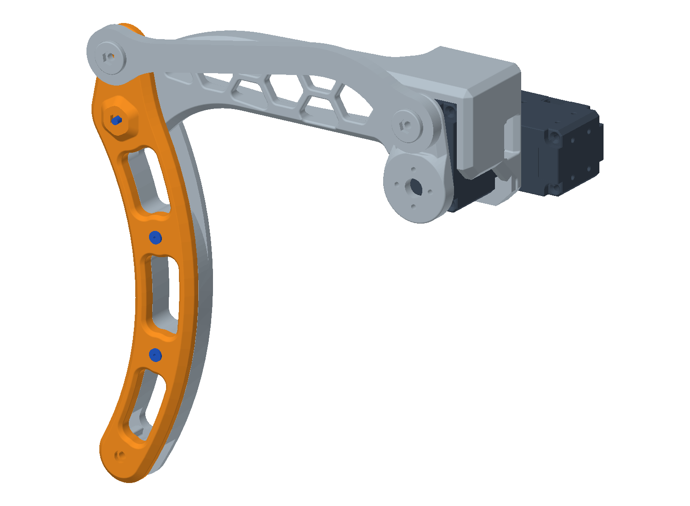
docs/assembly/manual_v2/assets/shank_a.png
