Leehyunbin0131/dog/docs/assembly/manual_v2/assets/shank_e.png

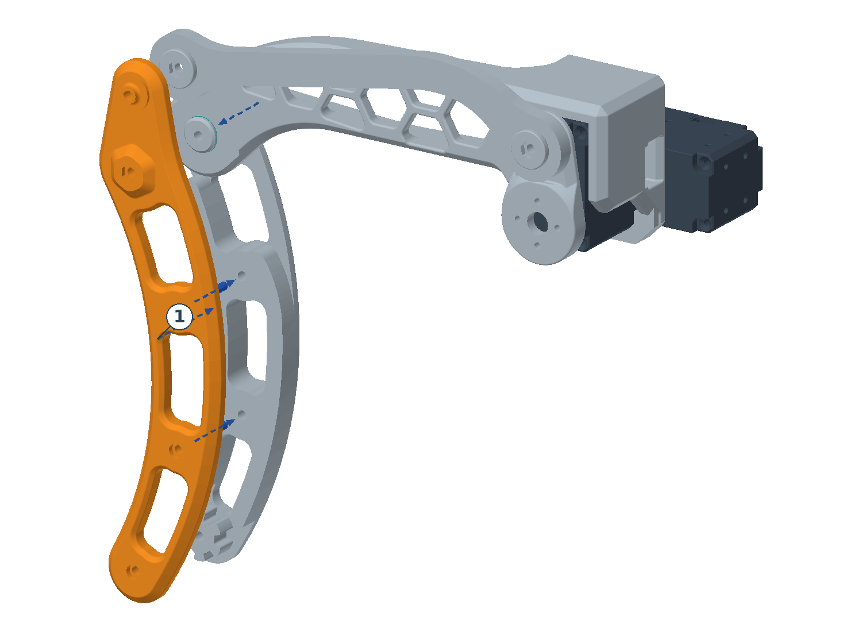
docs/assembly/manual_v2/assets/shank_e.png
