Leehyunbin0131/dog/docs/assembly/manual_v2/assets/washer_stack.png

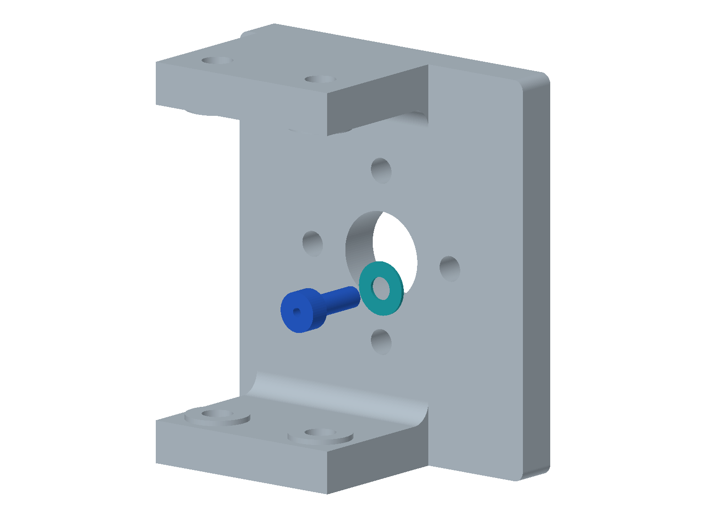
docs/assembly/manual_v2/assets/washer_stack.png
