Leehyunbin0131/dog/images/assembly/access_plus36.png

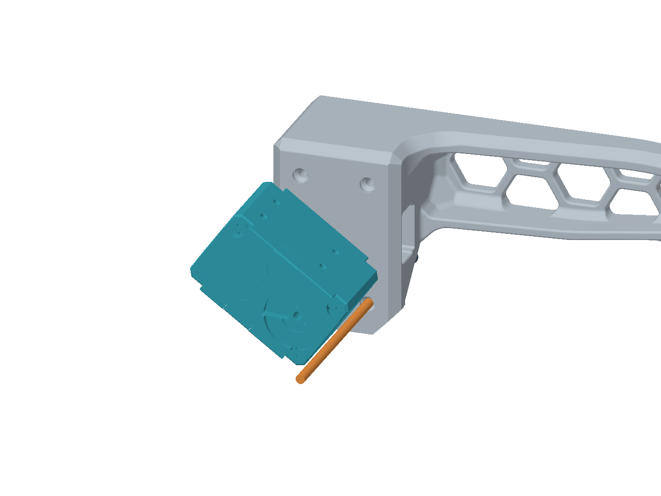
images/assembly/access_plus36.png
