Leehyunbin0131/dog/images/assembly/access_plus36_face.png

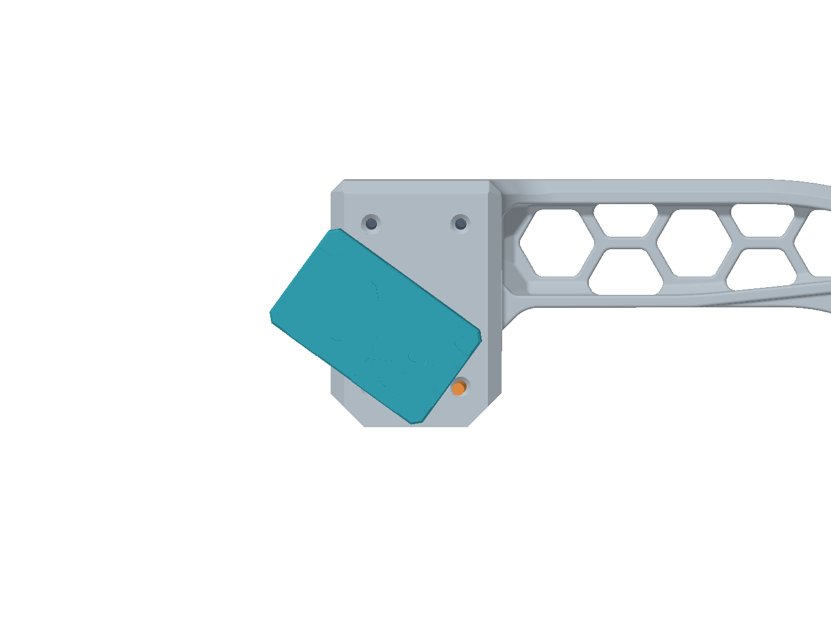
images/assembly/access_plus36_face.png
