Leehyunbin0131/dog/images/assembly/cables_a.png

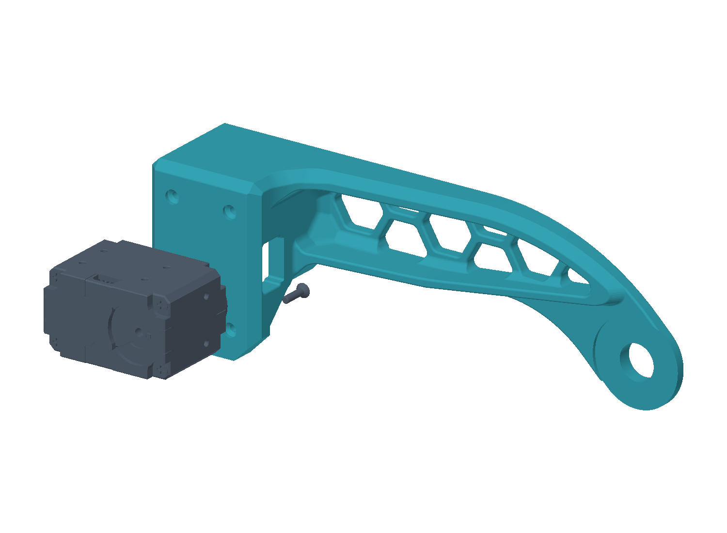
images/assembly/cables_a.png
