Leehyunbin0131/dog/images/assembly/carrier_a.png

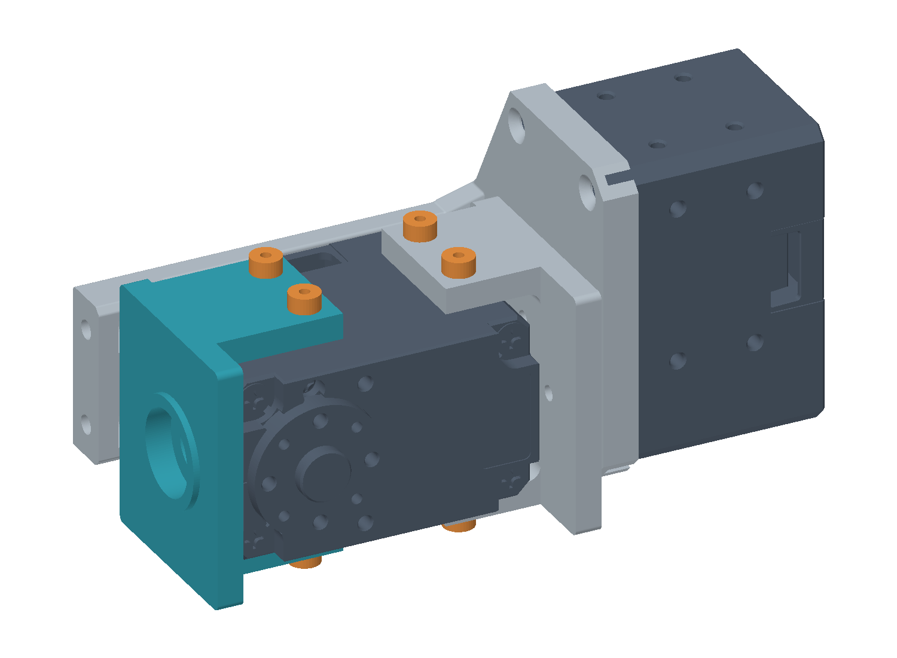
images/assembly/carrier_a.png
