Leehyunbin0131/dog/images/assembly/carrier_e.png

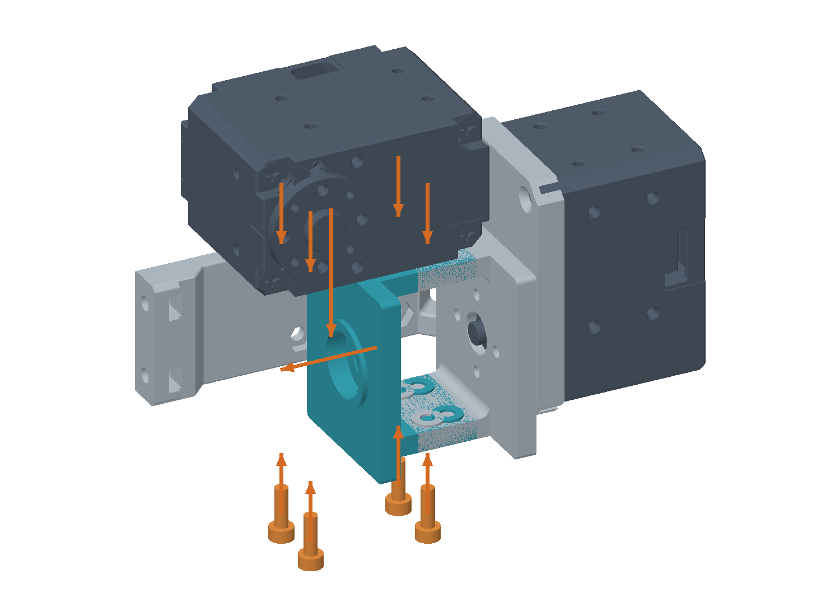
images/assembly/carrier_e.png
