Leehyunbin0131/dog/images/assembly/crank_a.png

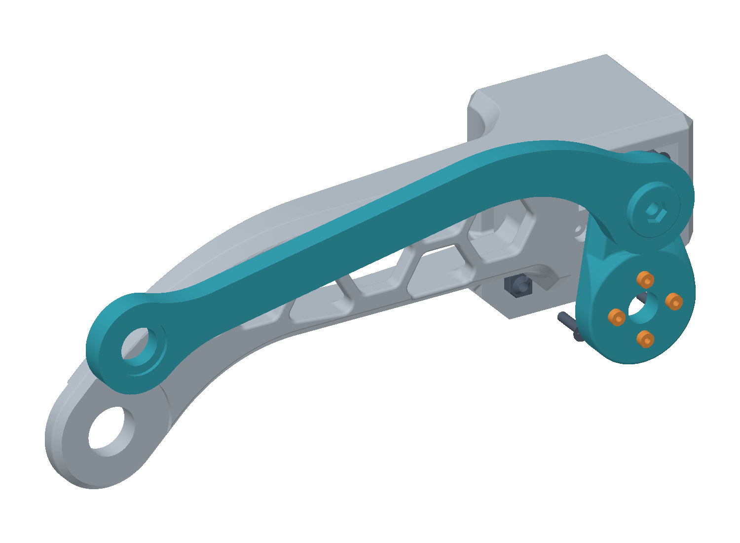
images/assembly/crank_a.png
