Leehyunbin0131/dog/images/assembly/crank_e.png

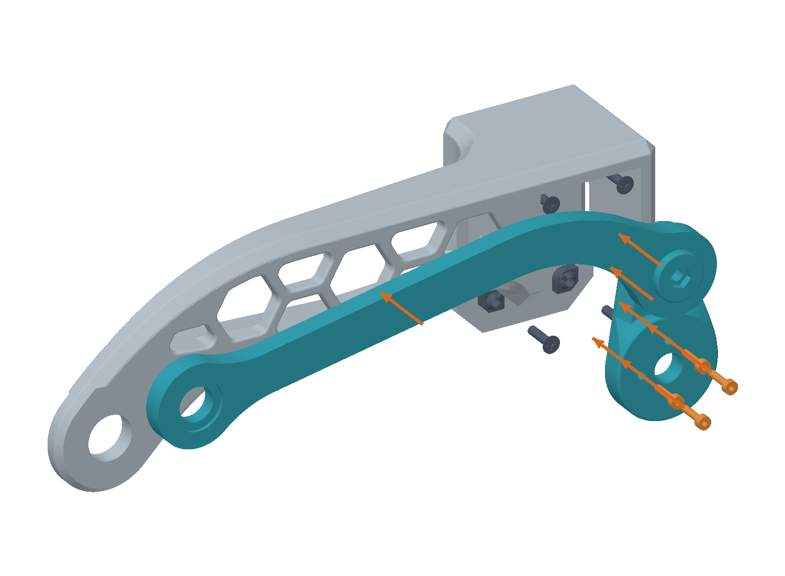
images/assembly/crank_e.png
