Leehyunbin0131/dog/images/assembly/distal_a.png

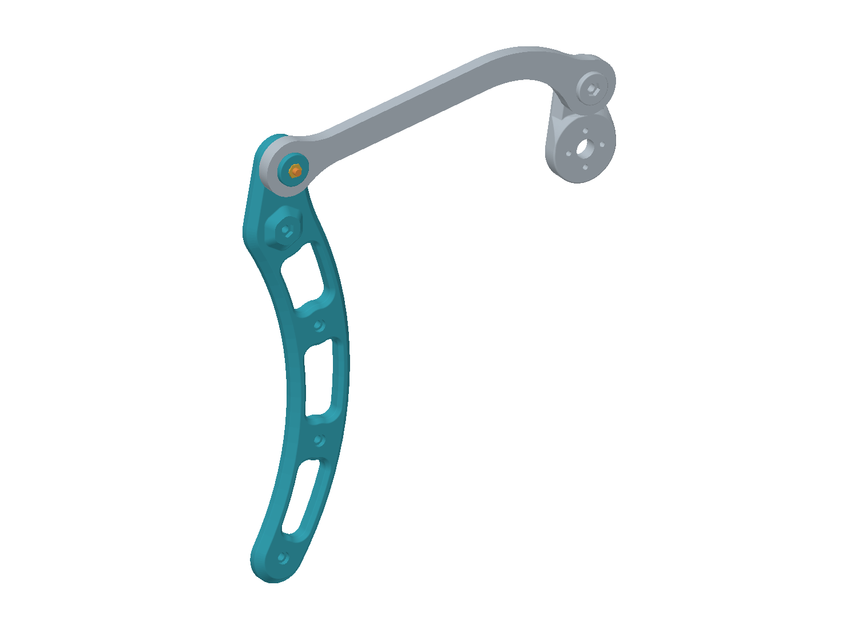
images/assembly/distal_a.png
