Leehyunbin0131/dog/images/assembly/distal_e.png

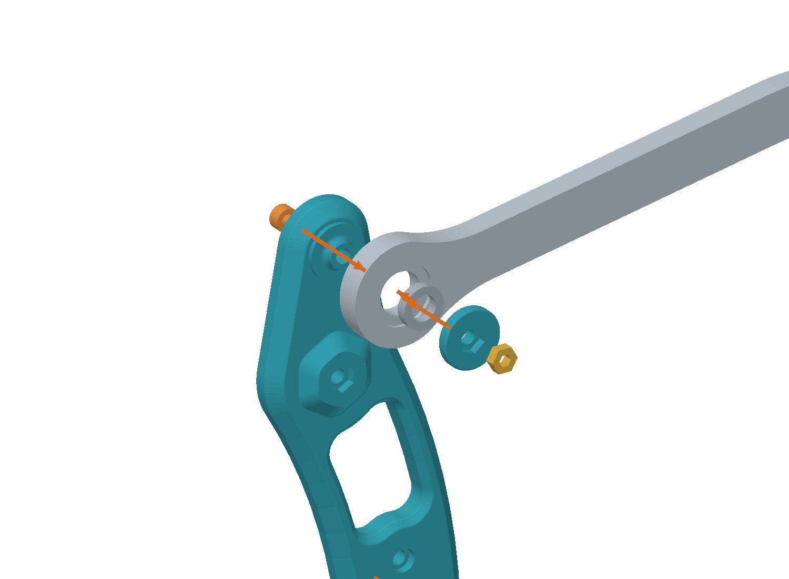
images/assembly/distal_e.png
