Leehyunbin0131/dog/images/assembly/foot_e.png

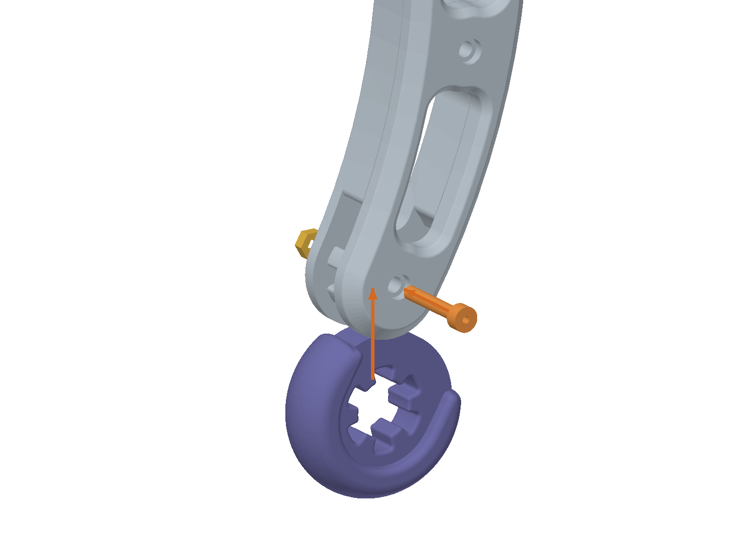
images/assembly/foot_e.png
