Leehyunbin0131/dog/images/assembly/four.png

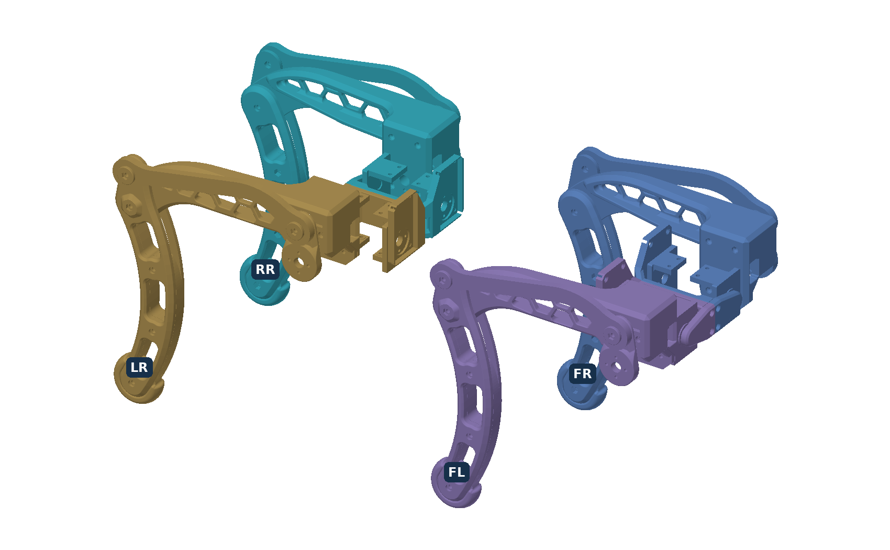
images/assembly/four.png
