Leehyunbin0131/dog/images/assembly/knee_e.png

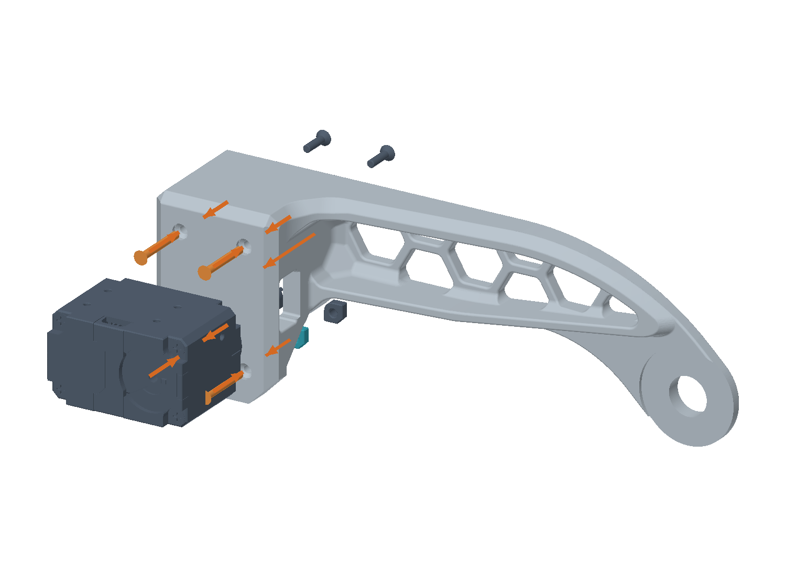
images/assembly/knee_e.png
