Leehyunbin0131/dog/images/assembly/large_e.png

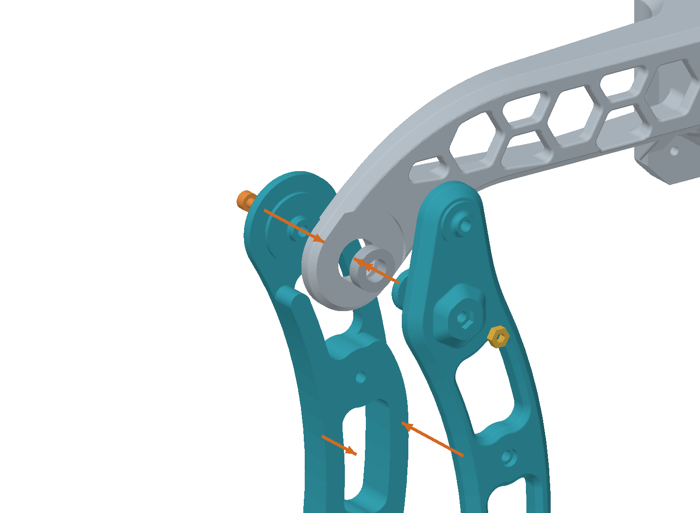
images/assembly/large_e.png
