Leehyunbin0131/dog/images/assembly/nut_yoke.png

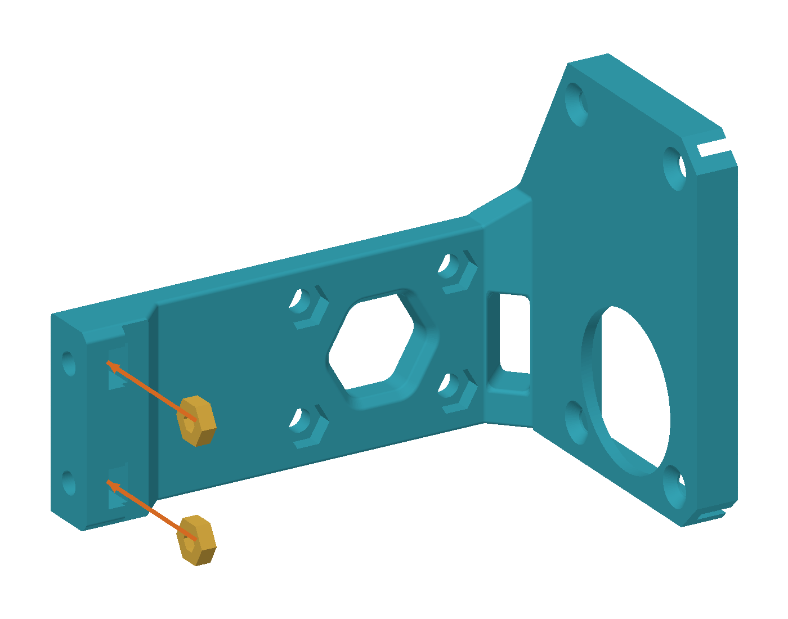
images/assembly/nut_yoke.png
