Leehyunbin0131/dog/images/assembly/part00.png

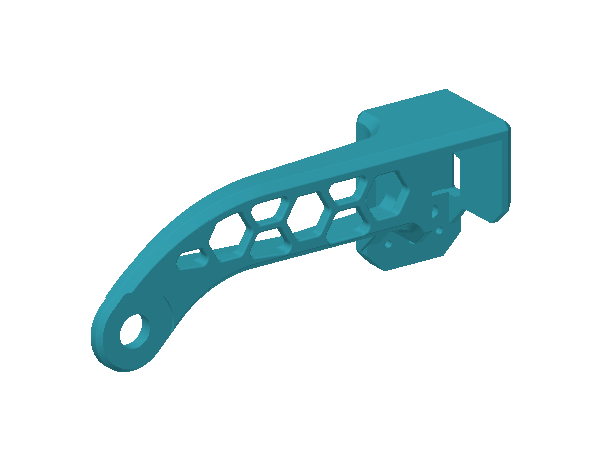
images/assembly/part00.png
