Leehyunbin0131/dog/images/assembly/part01.png

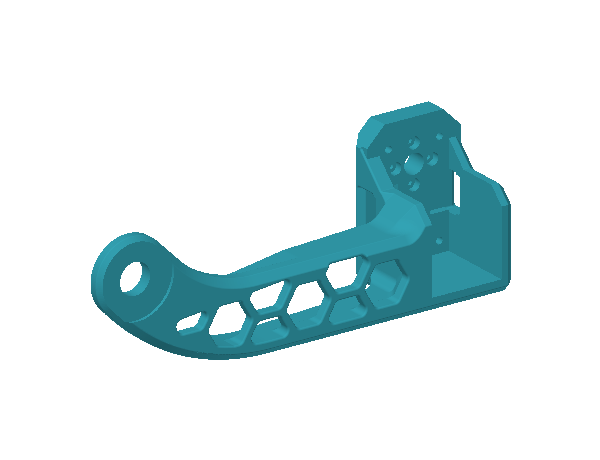
images/assembly/part01.png
