Leehyunbin0131/dog/images/assembly/part02.png

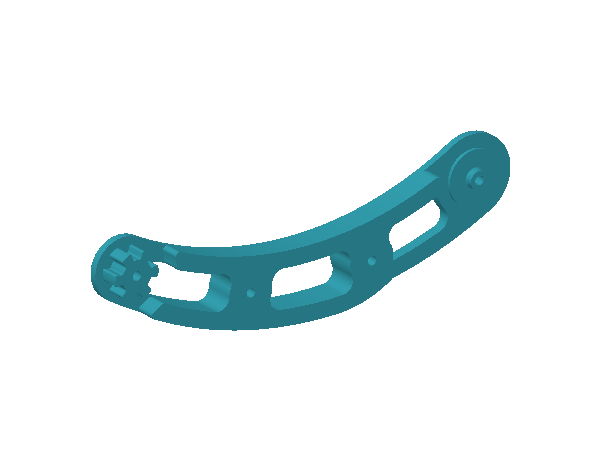
images/assembly/part02.png
