Leehyunbin0131/dog/images/assembly/part03.png

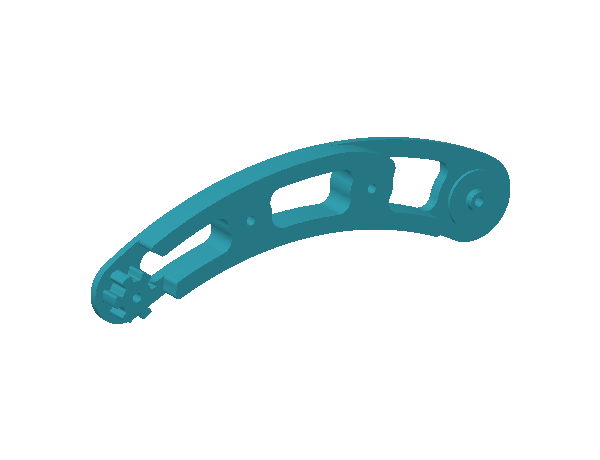
images/assembly/part03.png
