Leehyunbin0131/dog/images/assembly/part04.png

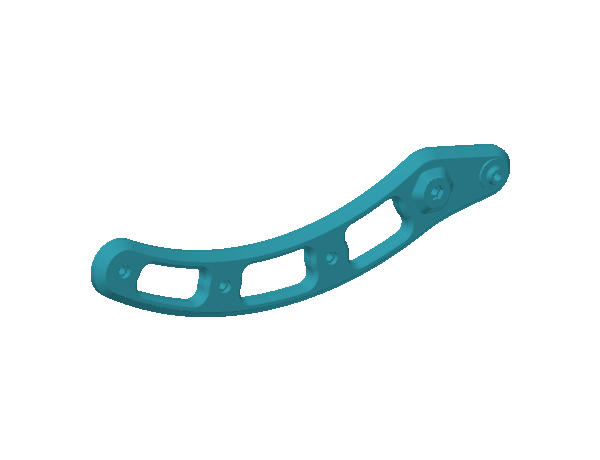
images/assembly/part04.png
