Leehyunbin0131/dog/images/assembly/part05.png

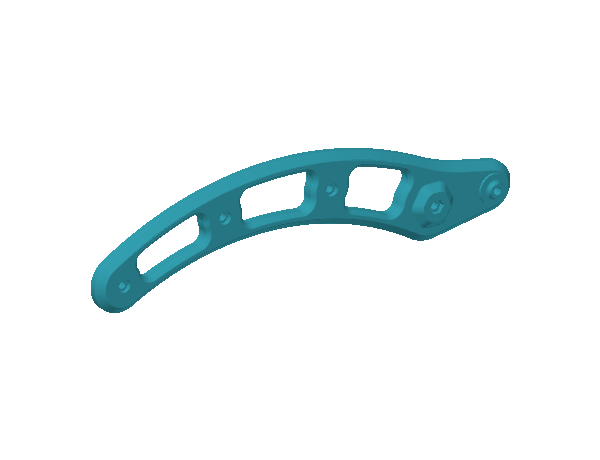
images/assembly/part05.png
