Leehyunbin0131/dog/images/assembly/part06.png

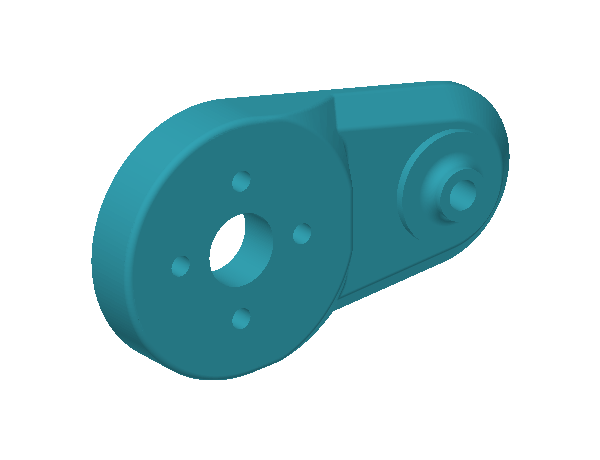
images/assembly/part06.png
