Leehyunbin0131/dog/images/assembly/part07.png

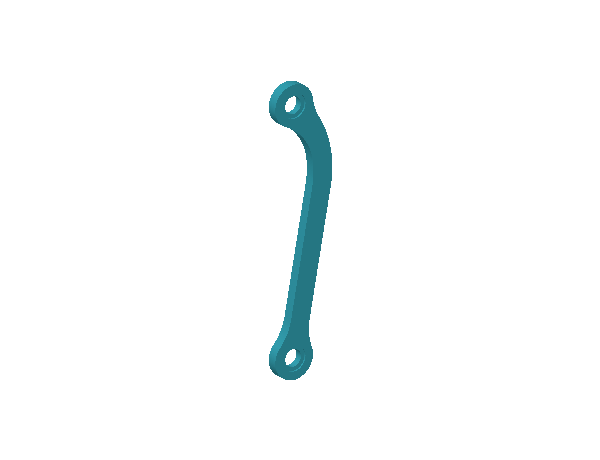
images/assembly/part07.png
