Leehyunbin0131/dog/images/assembly/part08.png

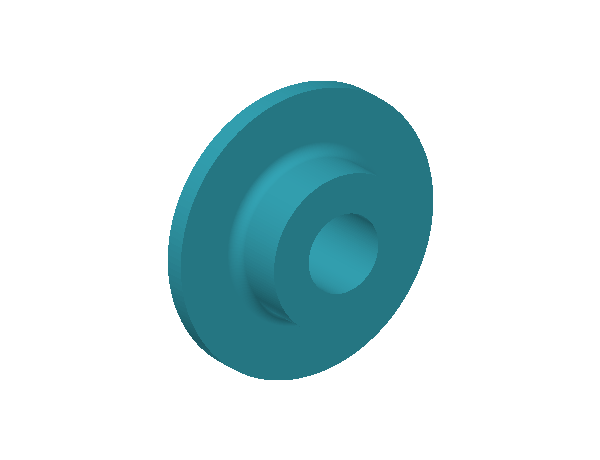
images/assembly/part08.png
