Leehyunbin0131/dog/images/assembly/part11.png

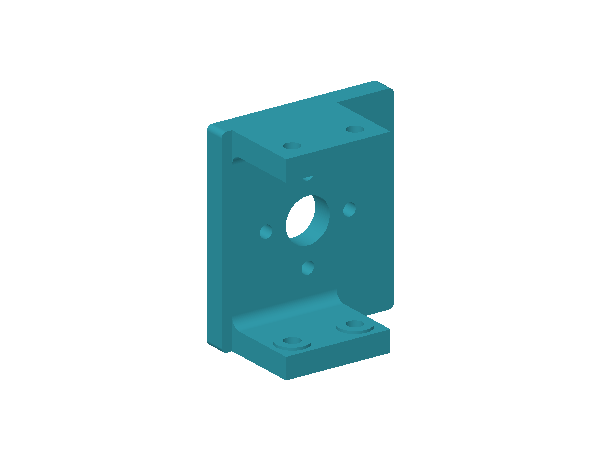
images/assembly/part11.png
