Leehyunbin0131/dog/images/assembly/part13.png

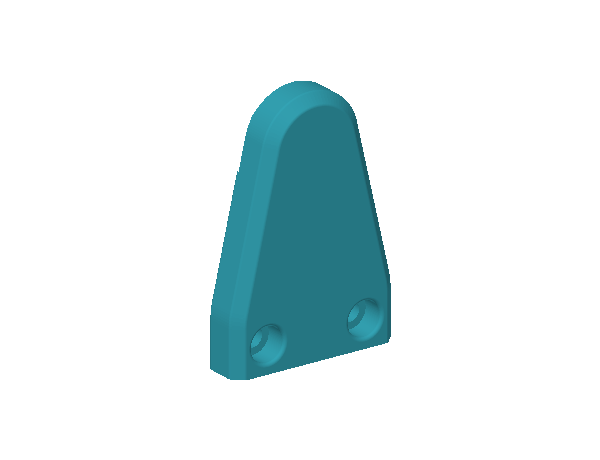
images/assembly/part13.png
