Leehyunbin0131/dog/images/assembly/part14.png

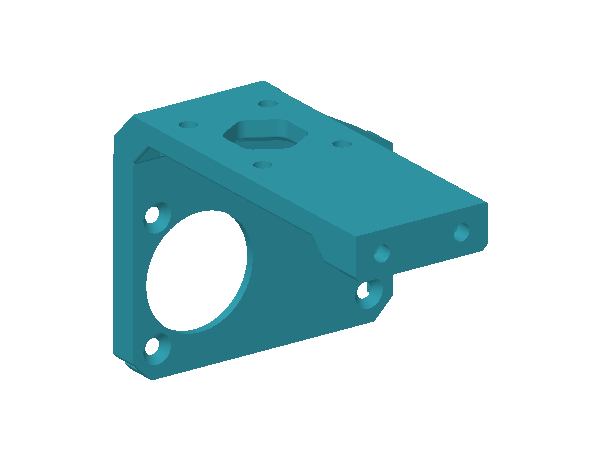
images/assembly/part14.png
