Leehyunbin0131/dog/images/assembly/part15.png

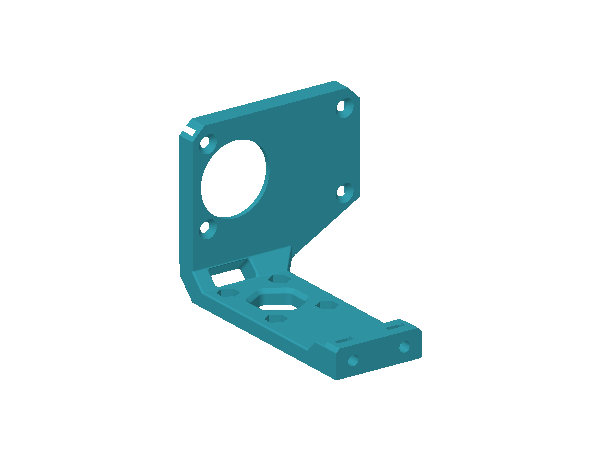
images/assembly/part15.png
