Leehyunbin0131/dog/images/assembly/part16.png

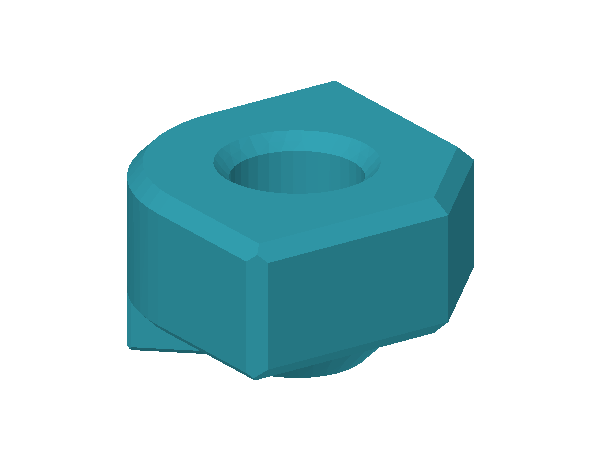
images/assembly/part16.png
