Leehyunbin0131/dog/images/assembly/part17.png

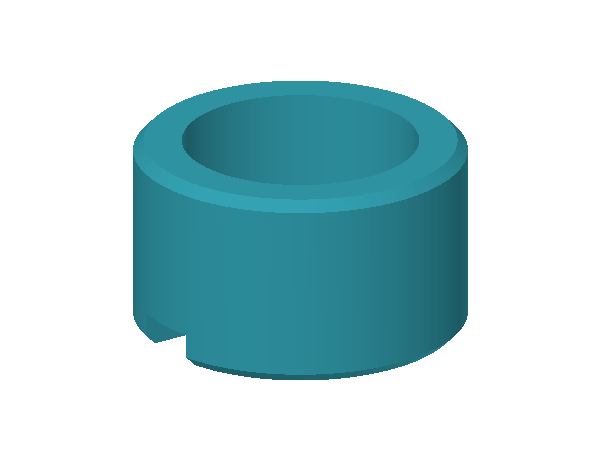
images/assembly/part17.png
