Leehyunbin0131/dog/images/assembly/pelvis_a.png

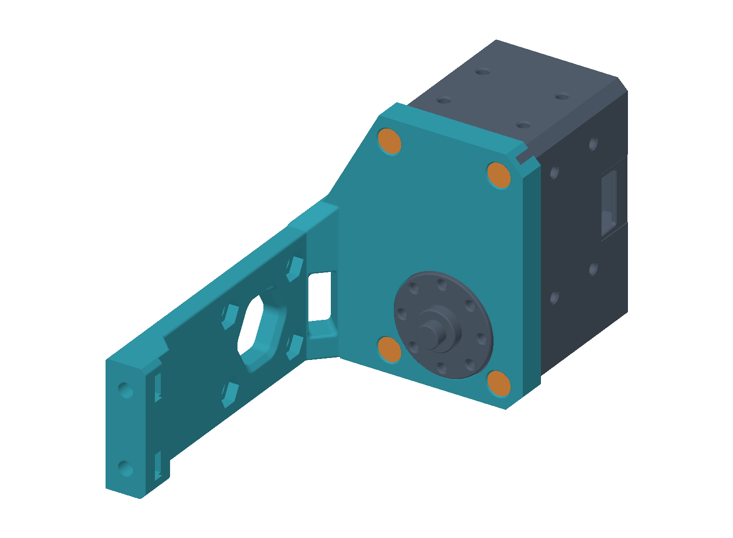
images/assembly/pelvis_a.png
