Leehyunbin0131/dog/images/assembly/pelvis_e.png

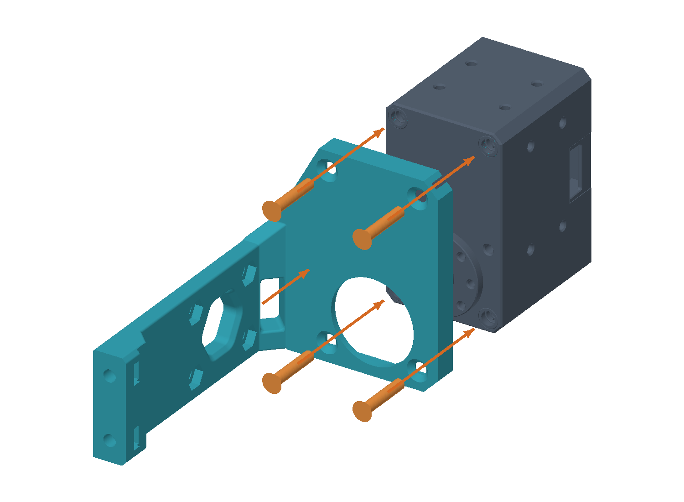
images/assembly/pelvis_e.png
