Leehyunbin0131/dog/descriptions/micro_dog_x430_description/validation/bent.png

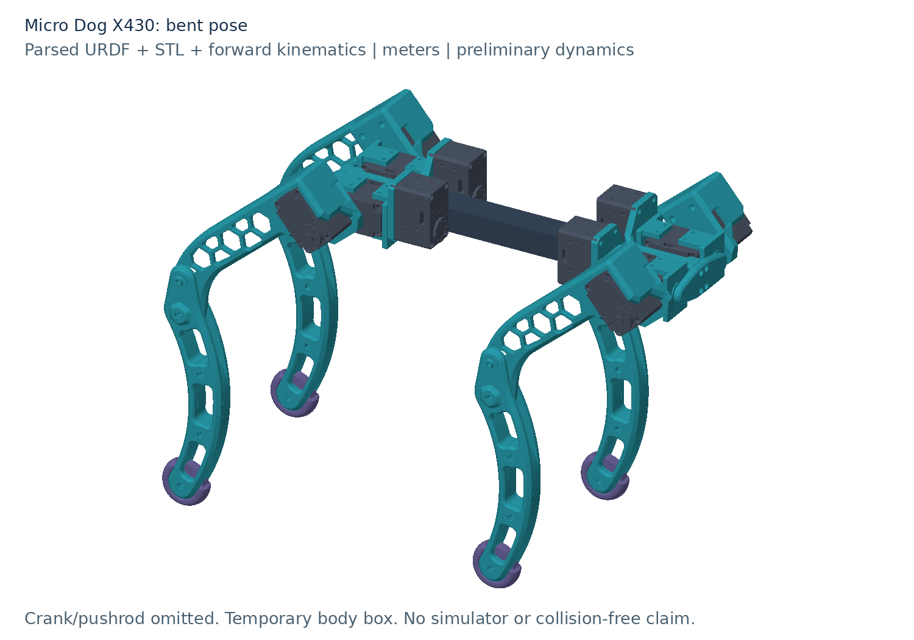
descriptions/micro_dog_x430_description/validation/bent.png
