Leehyunbin0131/dog/descriptions/micro_dog_x430_description/validation/neutral.png

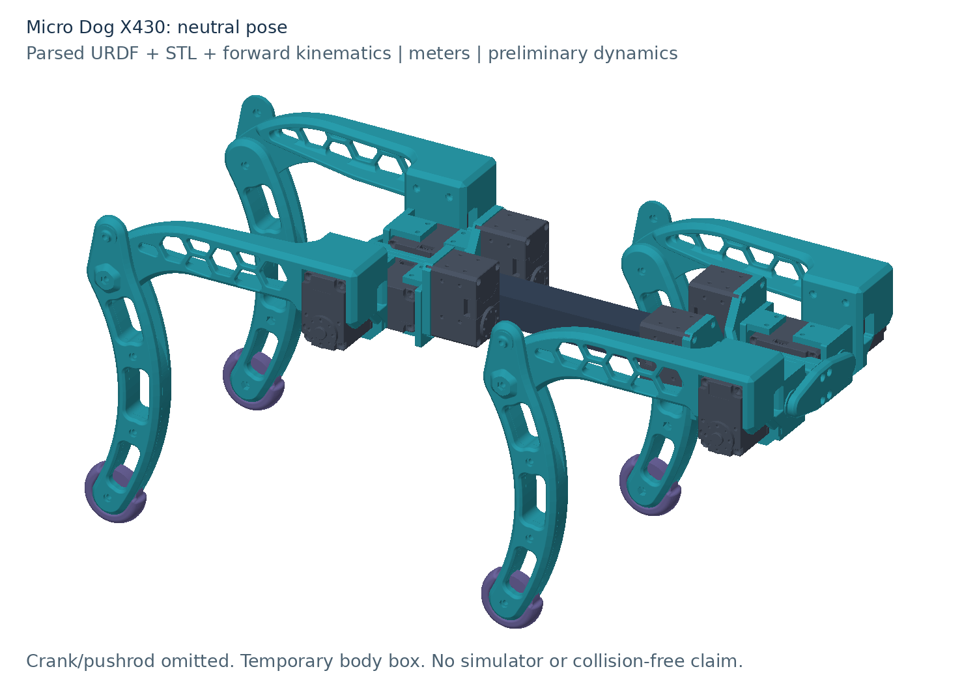
descriptions/micro_dog_x430_description/validation/neutral.png
