Leehyunbin0131/dog/descriptions/micro_dog_x430_description/urdf/micro_dog_x430.urdf

<?xml version='1.0' encoding='utf-8'?>
<robot name="micro_dog_x430">
  <!--CAD-derived visuals. Preliminary mass/inertia/limits. Knee is an equivalent serial joint, NOT motor shaft angle.-->
  <material name="body">
    <color rgba="0.22 0.28 0.36 1" />
  </material>
  <material name="printed">
    <color rgba="0.16 0.62 0.68 1" />
  </material>
  <material name="motor">
    <color rgba="0.30 0.34 0.40 1" />
  </material>
  <material name="foot">
    <color rgba="0.43 0.40 0.62 1" />
  </material>
  <link name="base_link">
    <visual>
      <origin xyz="0 0 0" rpy="0 0 0" />
      <geometry>
        <box size="0.18 0.024 0.02" />
      </geometry>
      <material name="body" />
    </visual>
    <collision>
      <origin xyz="0 0 0" rpy="0 0 0" />
      <geometry>
        <box size="0.18 0.024 0.02" />
      </geometry>
    </collision>
    <inertial>
      <origin xyz="0 0 0" rpy="0 0 0" />
      <mass value="1.08" />
      <inertia ixx="0.0006524799999999998" iyy="0.006171999999999999" izz="0.0065844799999999985" ixy="0.0" ixz="0.0" iyz="0.0" />
    </inertial>
    <visual>
      <origin xyz="-0.095 -0.029 0" rpy="0 0 0" />
      <geometry>
        <mesh filename="../meshes/RR_base_printed.stl" scale="1 1 1" />
      </geometry>
      <material name="printed" />
    </visual>
    <visual>
      <origin xyz="-0.095 -0.029 0" rpy="0 0 0" />
      <geometry>
        <mesh filename="../meshes/RR_base_motor.stl" scale="1 1 1" />
      </geometry>
      <material name="motor" />
    </visual>
    <visual>
      <origin xyz="-0.095 0.029 0" rpy="0 0 0" />
      <geometry>
        <mesh filename="../meshes/RL_base_printed.stl" scale="1 1 1" />
      </geometry>
      <material name="printed" />
    </visual>
    <visual>
      <origin xyz="-0.095 0.029 0" rpy="0 0 0" />
      <geometry>
        <mesh filename="../meshes/RL_base_motor.stl" scale="1 1 1" />
      </geometry>
      <material name="motor" />
    </visual>
    <visual>
      <origin xyz="0.095 -0.029 0" rpy="0 0 0" />
      <geometry>
        <mesh filename="../meshes/FR_base_printed.stl" scale="1 1 1" />
      </geometry>
      <material name="printed" />
    </visual>
    <visual>
      <origin xyz="0.095 -0.029 0" rpy="0 0 0" />
      <geometry>
        <mesh filename="../meshes/FR_base_motor.stl" scale="1 1 1" />
      </geometry>
      <material name="motor" />
    </visual>
    <visual>
      <origin xyz="0.095 0.029 0" rpy="0 0 0" />
      <geometry>
        <mesh filename="../meshes/FL_base_printed.stl" scale="1 1 1" />
      </geometry>
      <material name="printed" />
    </visual>
    <visual>
      <origin xyz="0.095 0.029 0" rpy="0 0 0" />
      <geometry>
        <mesh filename="../meshes/FL_base_motor.stl" scale="1 1 1" />
      </geometry>
      <material name="motor" />
    </visual>
  </link>
  <link name="RR_hip">
    <visual>
      <origin xyz="0 0 0" rpy="0 0 0" />
      <geometry>
        <mesh filename="../meshes/RR_hip_printed.stl" scale="1 1 1" />
      </geometry>
      <material name="printed" />
    </visual>
    <visual>
      <origin xyz="0 0 0" rpy="0 0 0" />
      <geometry>
        <mesh filename="../meshes/RR_hip_motor.stl" scale="1 1 1" />
      </geometry>
      <material name="motor" />
    </visual>
    <inertial>
      <origin xyz="-0.02575 0.004 0" rpy="0 0 0" />
      <mass value="0.09" />
      <inertia ixx="2.3154374999999998e-05" iyy="3.7098749999999994e-05" izz="3.9159374999999995e-05" ixy="0" ixz="0" iyz="0" />
    </inertial>
    <collision>
      <origin xyz="-0.02575 0.004 0" rpy="0 0 0" />
      <geometry>
        <box size="0.0595 0.041 0.0375" />
      </geometry>
    </collision>
  </link>
  <link name="RR_thigh">
    <visual>
      <origin xyz="0 0 0" rpy="0 0 0" />
      <geometry>
        <mesh filename="../meshes/RR_thigh_printed.stl" scale="1 1 1" />
      </geometry>
      <material name="printed" />
    </visual>
    <visual>
      <origin xyz="0 0 0" rpy="0 0 0" />
      <geometry>
        <mesh filename="../meshes/RR_thigh_motor.stl" scale="1 1 1" />
      </geometry>
      <material name="motor" />
    </visual>
    <inertial>
      <origin xyz="-0.06862438805 -0.02355 0.012375" rpy="0 0 0" />
      <mass value="0.12" />
      <inertia ixx="5.8901725000001044e-05" iyy="0.0003582068623570538" izz="0.00034329733735705457" ixy="0" ixz="0" iyz="0" />
    </inertial>
    <collision>
      <origin xyz="-0.06862438805 -0.02355 0.012375" rpy="0 0 0" />
      <geometry>
        <box size="0.1792487761 0.0469 0.06075" />
      </geometry>
    </collision>
  </link>
  <link name="RR_shank">
    <visual>
      <origin xyz="0 0 0" rpy="0 0 0" />
      <geometry>
        <mesh filename="../meshes/RR_shank_printed.stl" scale="1 1 1" />
      </geometry>
      <material name="printed" />
    </visual>
    <inertial>
      <origin xyz="0.00897727314 -0.0014375 -0.05924836475" rpy="0 0 0" />
      <mass value="0.07" />
      <inertia ixx="0.00022835009359258309" iyy="0.0002394971271689699" izz="1.7385965868053547e-05" ixy="0" ixz="0" iyz="0" />
    </inertial>
    <collision>
      <origin xyz="0.00897727314 -0.0014375 -0.05924836475" rpy="0 0 0" />
      <geometry>
        <box size="0.04945387413 0.023125 0.1964967295" />
      </geometry>
    </collision>
  </link>
  <link name="RR_foot">
    <visual>
      <origin xyz="0 0 0" rpy="0 0 0" />
      <geometry>
        <mesh filename="../meshes/RR_foot_foot.stl" scale="1 1 1" />
      </geometry>
      <material name="foot" />
    </visual>
    <inertial>
      <origin xyz="-1.747227498e-05 3.556183126e-17 -0.001437800063" rpy="0 0 0" />
      <mass value="0.02" />
      <inertia ixx="2.5130397347617853e-06" iyy="4.7047798729643285e-06" izz="2.8686151382025442e-06" ixy="0" ixz="0" iyz="0" />
    </inertial>
    <collision>
      <origin xyz="-1.747227498e-05 3.556183126e-17 -0.001437800063" rpy="0 0 0" />
      <geometry>
        <box size="0.03896288725 0.01425 0.03612148032" />
      </geometry>
    </collision>
  </link>
  <joint name="RR_roll_joint" type="revolute">
    <parent link="base_link" />
    <child link="RR_hip" />
    <origin xyz="-0.095 -0.029 0" rpy="0 0 0" />
    <axis xyz="-1 0 0" />
    <limit lower="-0.6" upper="0.6" effort="1.0" velocity="2.0" />
    <dynamics damping="0.02" friction="0" />
  </joint>
  <joint name="RR_pitch_joint" type="revolute">
    <parent link="RR_hip" />
    <child link="RR_thigh" />
    <origin xyz="-0.03875 -0.0144 0" rpy="0 0 0" />
    <axis xyz="0 -1 0" />
    <limit lower="-1.2" upper="1.2" effort="0.5" velocity="2.0" />
    <dynamics damping="0.02" friction="0" />
  </joint>
  <joint name="RR_knee_joint" type="revolute">
    <parent link="RR_thigh" />
    <child link="RR_shank" />
    <origin xyz="-0.1425 -0.0381625 0" rpy="0 0 0" />
    <axis xyz="0 -1 0" />
    <limit lower="-1.4" upper="1.4" effort="0.5" velocity="2.0" />
    <dynamics damping="0.02" friction="0" />
  </joint>
  <joint name="RR_foot_joint" type="fixed">
    <parent link="RR_shank" />
    <child link="RR_foot" />
    <origin xyz="0 0 -0.1455" rpy="0 0 0" />
  </joint>
  <link name="RL_hip">
    <visual>
      <origin xyz="0 0 0" rpy="0 0 0" />
      <geometry>
        <mesh filename="../meshes/RL_hip_printed.stl" scale="1 1 1" />
      </geometry>
      <material name="printed" />
    </visual>
    <visual>
      <origin xyz="0 0 0" rpy="0 0 0" />
      <geometry>
        <mesh filename="../meshes/RL_hip_motor.stl" scale="1 1 1" />
      </geometry>
      <material name="motor" />
    </visual>
    <inertial>
      <origin xyz="-0.02575 -0.004 0" rpy="0 0 0" />
      <mass value="0.09" />
      <inertia ixx="2.3154374999999998e-05" iyy="3.7098749999999994e-05" izz="3.9159374999999995e-05" ixy="0" ixz="0" iyz="0" />
    </inertial>
    <collision>
      <origin xyz="-0.02575 -0.004 0" rpy="0 0 0" />
      <geometry>
        <box size="0.0595 0.041 0.0375" />
      </geometry>
    </collision>
  </link>
  <link name="RL_thigh">
    <visual>
      <origin xyz="0 0 0" rpy="0 0 0" />
      <geometry>
        <mesh filename="../meshes/RL_thigh_printed.stl" scale="1 1 1" />
      </geometry>
      <material name="printed" />
    </visual>
    <visual>
      <origin xyz="0 0 0" rpy="0 0 0" />
      <geometry>
        <mesh filename="../meshes/RL_thigh_motor.stl" scale="1 1 1" />
      </geometry>
      <material name="motor" />
    </visual>
    <inertial>
      <origin xyz="-0.06862438805 0.02355 0.012375" rpy="0 0 0" />
      <mass value="0.12" />
      <inertia ixx="5.8901725000001044e-05" iyy="0.0003582068623570538" izz="0.00034329733735705457" ixy="0" ixz="0" iyz="0" />
    </inertial>
    <collision>
      <origin xyz="-0.06862438805 0.02355 0.012375" rpy="0 0 0" />
      <geometry>
        <box size="0.1792487761 0.0469 0.06075" />
      </geometry>
    </collision>
  </link>
  <link name="RL_shank">
    <visual>
      <origin xyz="0 0 0" rpy="0 0 0" />
      <geometry>
        <mesh filename="../meshes/RL_shank_printed.stl" scale="1 1 1" />
      </geometry>
      <material name="printed" />
    </visual>
    <inertial>
      <origin xyz="0.00897727314 0.0014375 -0.05924836475" rpy="0 0 0" />
      <mass value="0.07" />
      <inertia ixx="0.00022835009359258309" iyy="0.0002394971271689699" izz="1.7385965868053547e-05" ixy="0" ixz="0" iyz="0" />
    </inertial>
    <collision>
      <origin xyz="0.00897727314 0.0014375 -0.05924836475" rpy="0 0 0" />
      <geometry>
        <box size="0.04945387413 0.023125 0.1964967295" />
      </geometry>
    </collision>
  </link>
  <link name="RL_foot">
    <visual>
      <origin xyz="0 0 0" rpy="0 0 0" />
      <geometry>
        <mesh filename="../meshes/RL_foot_foot.stl" scale="1 1 1" />
      </geometry>
      <material name="foot" />
    </visual>
    <inertial>
      <origin xyz="-1.747227498e-05 -3.556183126e-17 -0.001437800063" rpy="0 0 0" />
      <mass value="0.02" />
      <inertia ixx="2.5130397347617853e-06" iyy="4.7047798729643285e-06" izz="2.8686151382025442e-06" ixy="0" ixz="0" iyz="0" />
    </inertial>
    <collision>
      <origin xyz="-1.747227498e-05 -3.556183126e-17 -0.001437800063" rpy="0 0 0" />
      <geometry>
        <box size="0.03896288725 0.01425 0.03612148032" />
      </geometry>
    </collision>
  </link>
  <joint name="RL_roll_joint" type="revolute">
    <parent link="base_link" />
    <child link="RL_hip" />
    <origin xyz="-0.095 0.029 0" rpy="0 0 0" />
    <axis xyz="-1 0 0" />
    <limit lower="-0.6" upper="0.6" effort="1.0" velocity="2.0" />
    <dynamics damping="0.02" friction="0" />
  </joint>
  <joint name="RL_pitch_joint" type="revolute">
    <parent link="RL_hip" />
    <child link="RL_thigh" />
    <origin xyz="-0.03875 0.0144 0" rpy="0 0 0" />
    <axis xyz="0 1 0" />
    <limit lower="-1.2" upper="1.2" effort="0.5" velocity="2.0" />
    <dynamics damping="0.02" friction="0" />
  </joint>
  <joint name="RL_knee_joint" type="revolute">
    <parent link="RL_thigh" />
    <child link="RL_shank" />
    <origin xyz="-0.1425 0.0381625 0" rpy="0 0 0" />
    <axis xyz="0 1 0" />
    <limit lower="-1.4" upper="1.4" effort="0.5" velocity="2.0" />
    <dynamics damping="0.02" friction="0" />
  </joint>
  <joint name="RL_foot_joint" type="fixed">
    <parent link="RL_shank" />
    <child link="RL_foot" />
    <origin xyz="0 0 -0.1455" rpy="0 0 0" />
  </joint>
  <link name="FR_hip">
    <visual>
      <origin xyz="0 0 0" rpy="0 0 0" />
      <geometry>
        <mesh filename="../meshes/FR_hip_printed.stl" scale="1 1 1" />
      </geometry>
      <material name="printed" />
    </visual>
    <visual>
      <origin xyz="0 0 0" rpy="0 0 0" />
      <geometry>
        <mesh filename="../meshes/FR_hip_motor.stl" scale="1 1 1" />
      </geometry>
      <material name="motor" />
    </visual>
    <inertial>
      <origin xyz="0.02575 0.004 0" rpy="0 0 0" />
      <mass value="0.09" />
      <inertia ixx="2.3154374999999998e-05" iyy="3.7098749999999994e-05" izz="3.9159374999999995e-05" ixy="0" ixz="0" iyz="0" />
    </inertial>
    <collision>
      <origin xyz="0.02575 0.004 0" rpy="0 0 0" />
      <geometry>
        <box size="0.0595 0.041 0.0375" />
      </geometry>
    </collision>
  </link>
  <link name="FR_thigh">
    <visual>
      <origin xyz="0 0 0" rpy="0 0 0" />
      <geometry>
        <mesh filename="../meshes/FR_thigh_printed.stl" scale="1 1 1" />
      </geometry>
      <material name="printed" />
    </visual>
    <visual>
      <origin xyz="0 0 0" rpy="0 0 0" />
      <geometry>
        <mesh filename="../meshes/FR_thigh_motor.stl" scale="1 1 1" />
      </geometry>
      <material name="motor" />
    </visual>
    <inertial>
      <origin xyz="-0.06862438805 -0.02355 0.012375" rpy="0 0 0" />
      <mass value="0.12" />
      <inertia ixx="5.8901725000001044e-05" iyy="0.0003582068623570538" izz="0.0003432973373570546" ixy="0" ixz="0" iyz="0" />
    </inertial>
    <collision>
      <origin xyz="-0.06862438805 -0.02355 0.012375" rpy="0 0 0" />
      <geometry>
        <box size="0.1792487761 0.0469 0.06075" />
      </geometry>
    </collision>
  </link>
  <link name="FR_shank">
    <visual>
      <origin xyz="0 0 0" rpy="0 0 0" />
      <geometry>
        <mesh filename="../meshes/FR_shank_printed.stl" scale="1 1 1" />
      </geometry>
      <material name="printed" />
    </visual>
    <inertial>
      <origin xyz="0.00897727314 -0.0014375 -0.05924836475" rpy="0 0 0" />
      <mass value="0.07" />
      <inertia ixx="0.00022835009359258309" iyy="0.0002394971271689699" izz="1.7385965868053547e-05" ixy="0" ixz="0" iyz="0" />
    </inertial>
    <collision>
      <origin xyz="0.00897727314 -0.0014375 -0.05924836475" rpy="0 0 0" />
      <geometry>
        <box size="0.04945387413 0.023125 0.1964967295" />
      </geometry>
    </collision>
  </link>
  <link name="FR_foot">
    <visual>
      <origin xyz="0 0 0" rpy="0 0 0" />
      <geometry>
        <mesh filename="../meshes/FR_foot_foot.stl" scale="1 1 1" />
      </geometry>
      <material name="foot" />
    </visual>
    <inertial>
      <origin xyz="-1.747227498e-05 3.556183126e-17 -0.001437800063" rpy="0 0 0" />
      <mass value="0.02" />
      <inertia ixx="2.5130397347617853e-06" iyy="4.704779872964332e-06" izz="2.8686151382025476e-06" ixy="0" ixz="0" iyz="0" />
    </inertial>
    <collision>
      <origin xyz="-1.747227498e-05 3.556183126e-17 -0.001437800063" rpy="0 0 0" />
      <geometry>
        <box size="0.03896288725 0.01425 0.03612148032" />
      </geometry>
    </collision>
  </link>
  <joint name="FR_roll_joint" type="revolute">
    <parent link="base_link" />
    <child link="FR_hip" />
    <origin xyz="0.095 -0.029 0" rpy="0 0 0" />
    <axis xyz="1 0 0" />
    <limit lower="-0.6" upper="0.6" effort="1.0" velocity="2.0" />
    <dynamics damping="0.02" friction="0" />
  </joint>
  <joint name="FR_pitch_joint" type="revolute">
    <parent link="FR_hip" />
    <child link="FR_thigh" />
    <origin xyz="0.03875 -0.0144 0" rpy="0 0 0" />
    <axis xyz="0 -1 0" />
    <limit lower="-1.2" upper="1.2" effort="0.5" velocity="2.0" />
    <dynamics damping="0.02" friction="0" />
  </joint>
  <joint name="FR_knee_joint" type="revolute">
    <parent link="FR_thigh" />
    <child link="FR_shank" />
    <origin xyz="-0.1425 -0.0381625 0" rpy="0 0 0" />
    <axis xyz="0 -1 0" />
    <limit lower="-1.4" upper="1.4" effort="0.5" velocity="2.0" />
    <dynamics damping="0.02" friction="0" />
  </joint>
  <joint name="FR_foot_joint" type="fixed">
    <parent link="FR_shank" />
    <child link="FR_foot" />
    <origin xyz="0 0 -0.1455" rpy="0 0 0" />
  </joint>
  <link name="FL_hip">
    <visual>
      <origin xyz="0 0 0" rpy="0 0 0" />
      <geometry>
        <mesh filename="../meshes/FL_hip_printed.stl" scale="1 1 1" />
      </geometry>
      <material name="printed" />
    </visual>
    <visual>
      <origin xyz="0 0 0" rpy="0 0 0" />
      <geometry>
        <mesh filename="../meshes/FL_hip_motor.stl" scale="1 1 1" />
      </geometry>
      <material name="motor" />
    </visual>
    <inertial>
      <origin xyz="0.02575 -0.004 0" rpy="0 0 0" />
      <mass value="0.09" />
      <inertia ixx="2.3154374999999998e-05" iyy="3.7098749999999994e-05" izz="3.9159374999999995e-05" ixy="0" ixz="0" iyz="0" />
    </inertial>
    <collision>
      <origin xyz="0.02575 -0.004 0" rpy="0 0 0" />
      <geometry>
        <box size="0.0595 0.041 0.0375" />
      </geometry>
    </collision>
  </link>
  <link name="FL_thigh">
    <visual>
      <origin xyz="0 0 0" rpy="0 0 0" />
      <geometry>
        <mesh filename="../meshes/FL_thigh_printed.stl" scale="1 1 1" />
      </geometry>
      <material name="printed" />
    </visual>
    <visual>
      <origin xyz="0 0 0" rpy="0 0 0" />
      <geometry>
        <mesh filename="../meshes/FL_thigh_motor.stl" scale="1 1 1" />
      </geometry>
      <material name="motor" />
    </visual>
    <inertial>
      <origin xyz="-0.06862438805 0.02355 0.012375" rpy="0 0 0" />
      <mass value="0.12" />
      <inertia ixx="5.8901725000001044e-05" iyy="0.0003582068623570538" izz="0.0003432973373570546" ixy="0" ixz="0" iyz="0" />
    </inertial>
    <collision>
      <origin xyz="-0.06862438805 0.02355 0.012375" rpy="0 0 0" />
      <geometry>
        <box size="0.1792487761 0.0469 0.06075" />
      </geometry>
    </collision>
  </link>
  <link name="FL_shank">
    <visual>
      <origin xyz="0 0 0" rpy="0 0 0" />
      <geometry>
        <mesh filename="../meshes/FL_shank_printed.stl" scale="1 1 1" />
      </geometry>
      <material name="printed" />
    </visual>
    <inertial>
      <origin xyz="0.00897727314 0.0014375 -0.05924836475" rpy="0 0 0" />
      <mass value="0.07" />
      <inertia ixx="0.00022835009359258309" iyy="0.0002394971271689699" izz="1.7385965868053547e-05" ixy="0" ixz="0" iyz="0" />
    </inertial>
    <collision>
      <origin xyz="0.00897727314 0.0014375 -0.05924836475" rpy="0 0 0" />
      <geometry>
        <box size="0.04945387413 0.023125 0.1964967295" />
      </geometry>
    </collision>
  </link>
  <link name="FL_foot">
    <visual>
      <origin xyz="0 0 0" rpy="0 0 0" />
      <geometry>
        <mesh filename="../meshes/FL_foot_foot.stl" scale="1 1 1" />
      </geometry>
      <material name="foot" />
    </visual>
    <inertial>
      <origin xyz="-1.747227498e-05 -3.556183126e-17 -0.001437800063" rpy="0 0 0" />
      <mass value="0.02" />
      <inertia ixx="2.5130397347617853e-06" iyy="4.704779872964332e-06" izz="2.8686151382025476e-06" ixy="0" ixz="0" iyz="0" />
    </inertial>
    <collision>
      <origin xyz="-1.747227498e-05 -3.556183126e-17 -0.001437800063" rpy="0 0 0" />
      <geometry>
        <box size="0.03896288725 0.01425 0.03612148032" />
      </geometry>
    </collision>
  </link>
  <joint name="FL_roll_joint" type="revolute">
    <parent link="base_link" />
    <child link="FL_hip" />
    <origin xyz="0.095 0.029 0" rpy="0 0 0" />
    <axis xyz="1 0 0" />
    <limit lower="-0.6" upper="0.6" effort="1.0" velocity="2.0" />
    <dynamics damping="0.02" friction="0" />
  </joint>
  <joint name="FL_pitch_joint" type="revolute">
    <parent link="FL_hip" />
    <child link="FL_thigh" />
    <origin xyz="0.03875 0.0144 0" rpy="0 0 0" />
    <axis xyz="0 1 0" />
    <limit lower="-1.2" upper="1.2" effort="0.5" velocity="2.0" />
    <dynamics damping="0.02" friction="0" />
  </joint>
  <joint name="FL_knee_joint" type="revolute">
    <parent link="FL_thigh" />
    <child link="FL_shank" />
    <origin xyz="-0.1425 0.0381625 0" rpy="0 0 0" />
    <axis xyz="0 1 0" />
    <limit lower="-1.4" upper="1.4" effort="0.5" velocity="2.0" />
    <dynamics damping="0.02" friction="0" />
  </joint>
  <joint name="FL_foot_joint" type="fixed">
    <parent link="FL_shank" />
    <child link="FL_foot" />
    <origin xyz="0 0 -0.1455" rpy="0 0 0" />
  </joint>
</robot>
