Leehyunbin0131/dog/(commit log)

2026-10-17 Add Micro_Dog X430 CAD, Korean assembly manual, BOM and validated parametric URDF
    [FL_base_motor.stl, FL_base_printed.stl, FL_foot_foot.stl, FL_hip_motor.stl, FL_hip_printed.stl, FL_shank_printed.stl, FL_thigh_motor.stl, FL_thigh_printed.stl]
2026-10-17 Replace assembly manual with reviewed CAD-based REV 2 and reproducible sources
2026-10-17 Publish validated v6 thigh cleanup pair and purchase-impact documentation
    [LH_XL430_thigh_finish_v2.FCStd, LH_XL430_thigh_finish_v2.step, LH_XL430_thigh_finish_v6.step, LH_XL430_thigh_finish_v6_fine005.stl, RR_XL430_thigh_finish_v2.step, RR_XL430_thigh_finish_v6.step, RR_XL430_thigh_finish_v6_fine005.stl, printed_parts.csv]
2026-10-18 Restore user-selected v2 thigh release and matching manifests
    [LH_XL430_thigh_finish_v2.FCStd, LH_XL430_thigh_finish_v2.step, LH_XL430_thigh_finish_v6.step, LH_XL430_thigh_finish_v6_fine005.stl, RR_XL430_thigh_finish_v2.step, RR_XL430_thigh_finish_v6.step, RR_XL430_thigh_finish_v6_fine005.stl, printed_parts.csv]
